alaviali/OBI/Images/IMG_3639.JPG

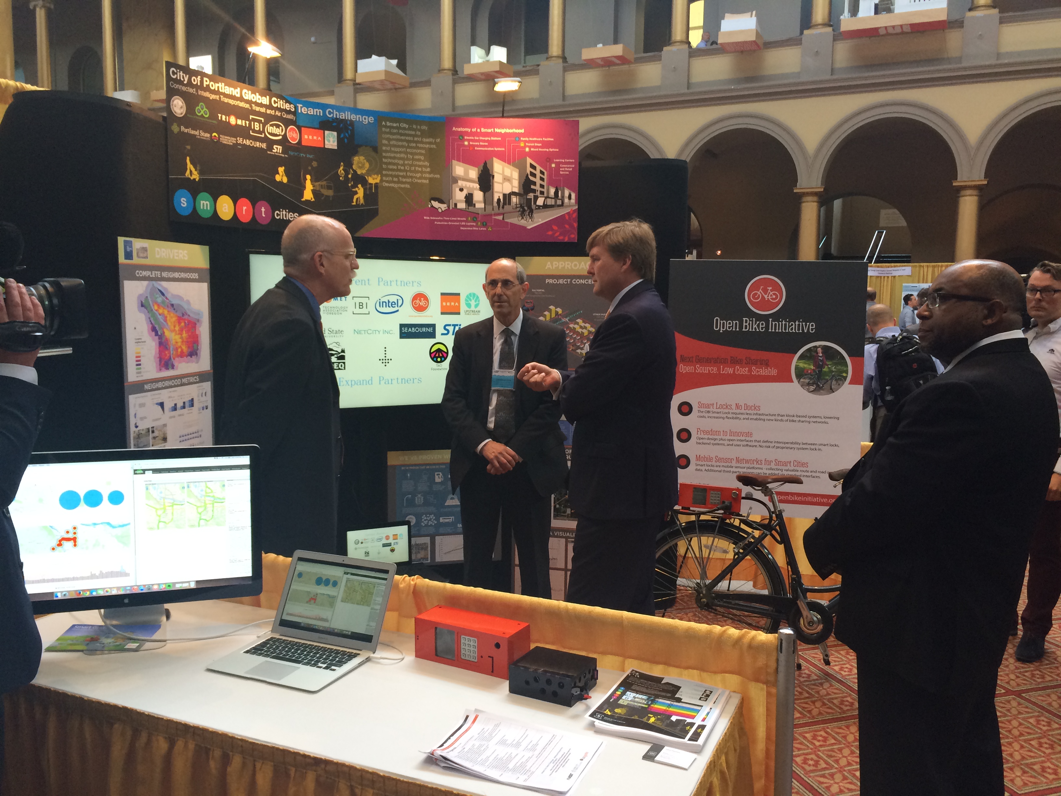
Images/IMG_3639.JPG
