alaviali/OBI/Images and PDFs/PCB_Final.png

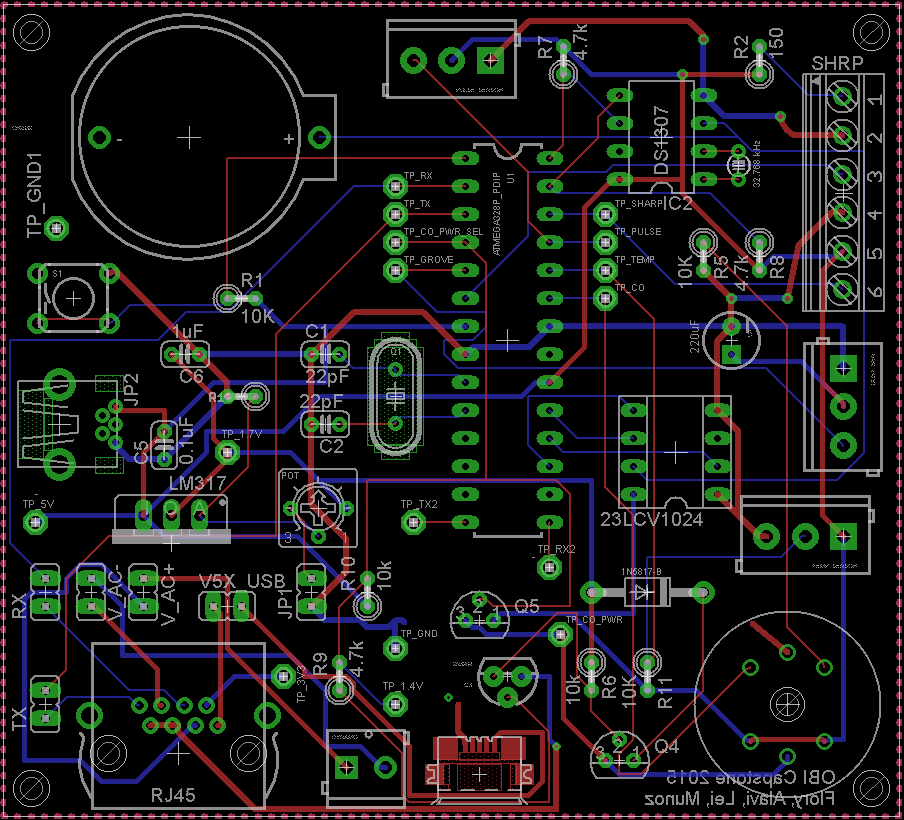
Images and PDFs/PCB_Final.png
