alaviali/OBI/Images and PDFs/Schematic_final.png

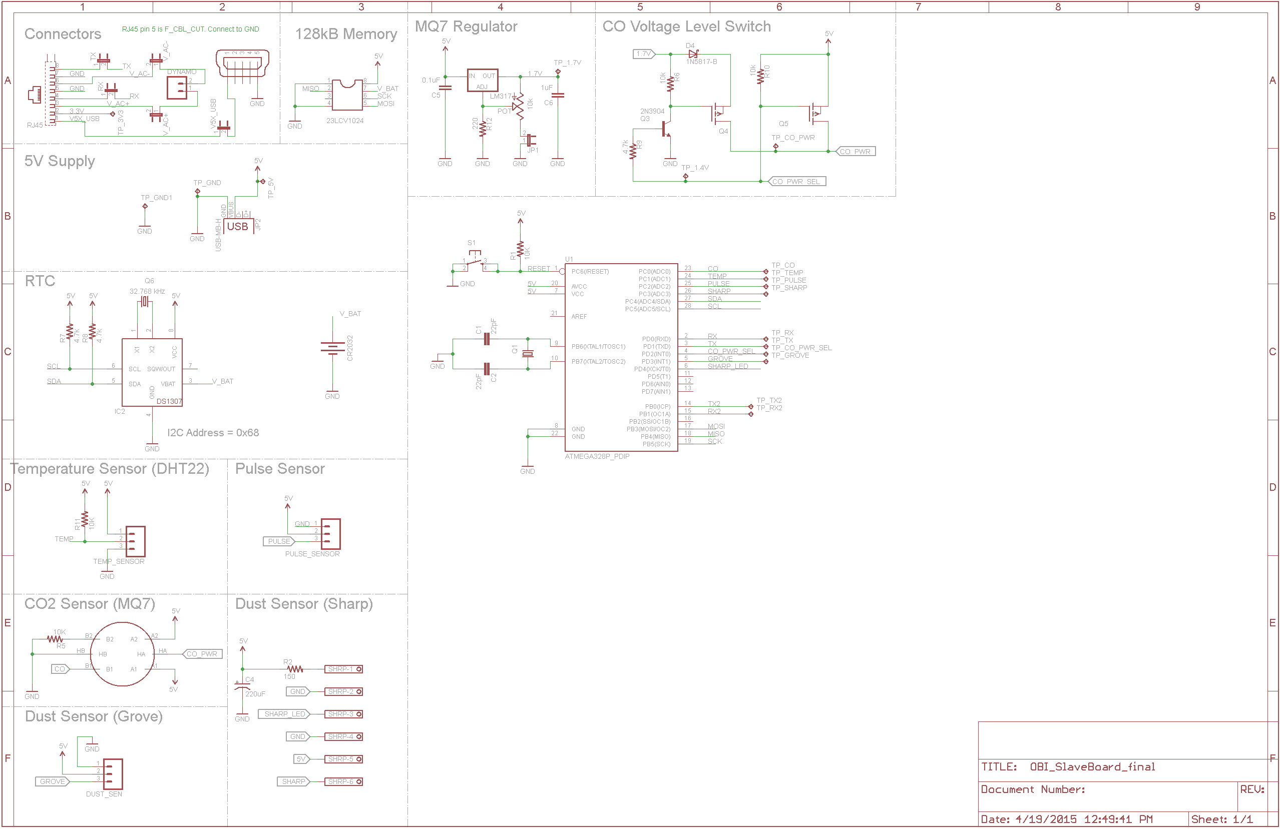
Images and PDFs/Schematic_final.png
