alaviali/OBI/Images/AQSH_ASM_Page_1.jpg

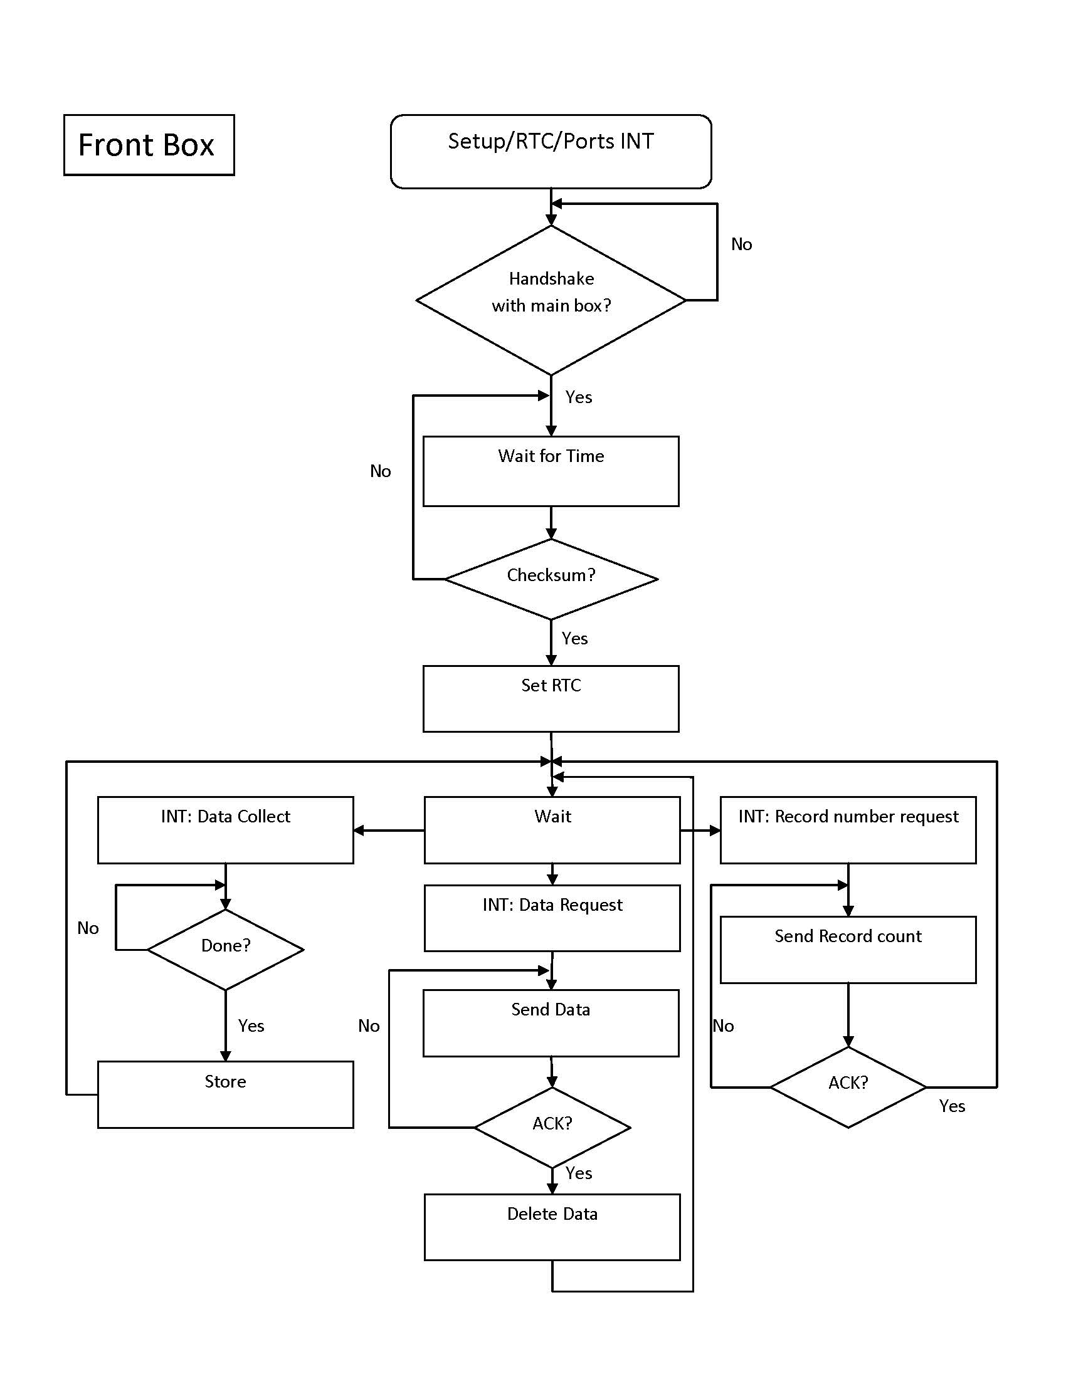
Images/AQSH_ASM_Page_1.jpg
