alaviali/OBI/Images/AQSH_ASM_Page_2.jpg

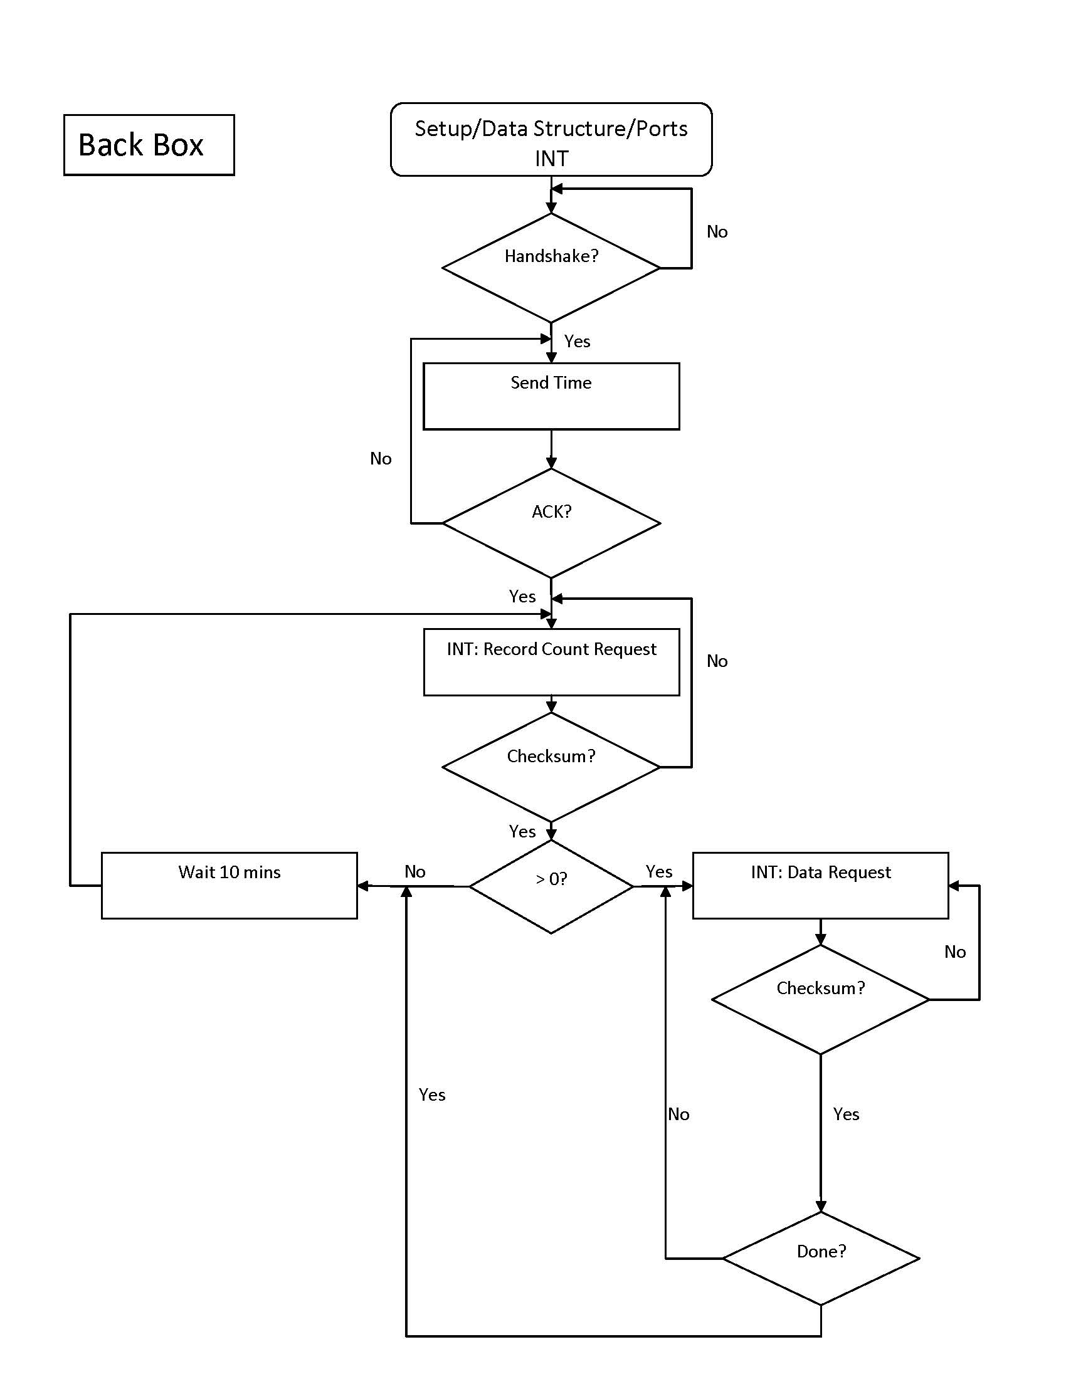
Images/AQSH_ASM_Page_2.jpg
