alaviali/OBI/Images/image7.JPG

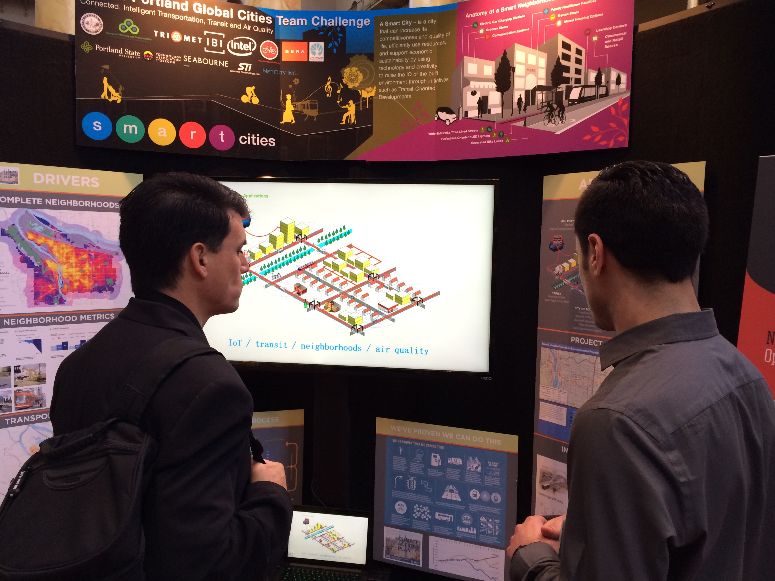
Images/image7.JPG
