alaviali/OBI/Images/IMG_3504.JPG

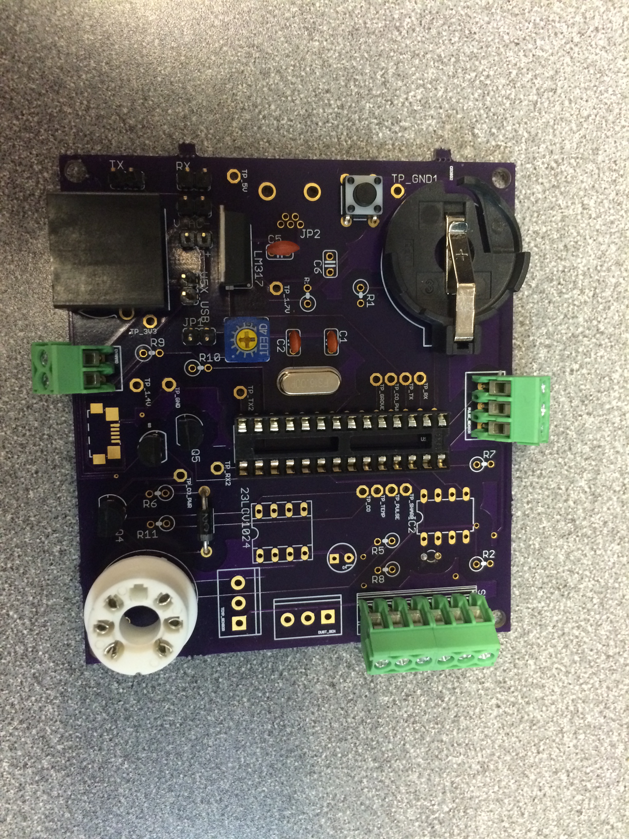
Images/IMG_3504.JPG
