alaviali/OBI/Images/IMG_3506.JPG

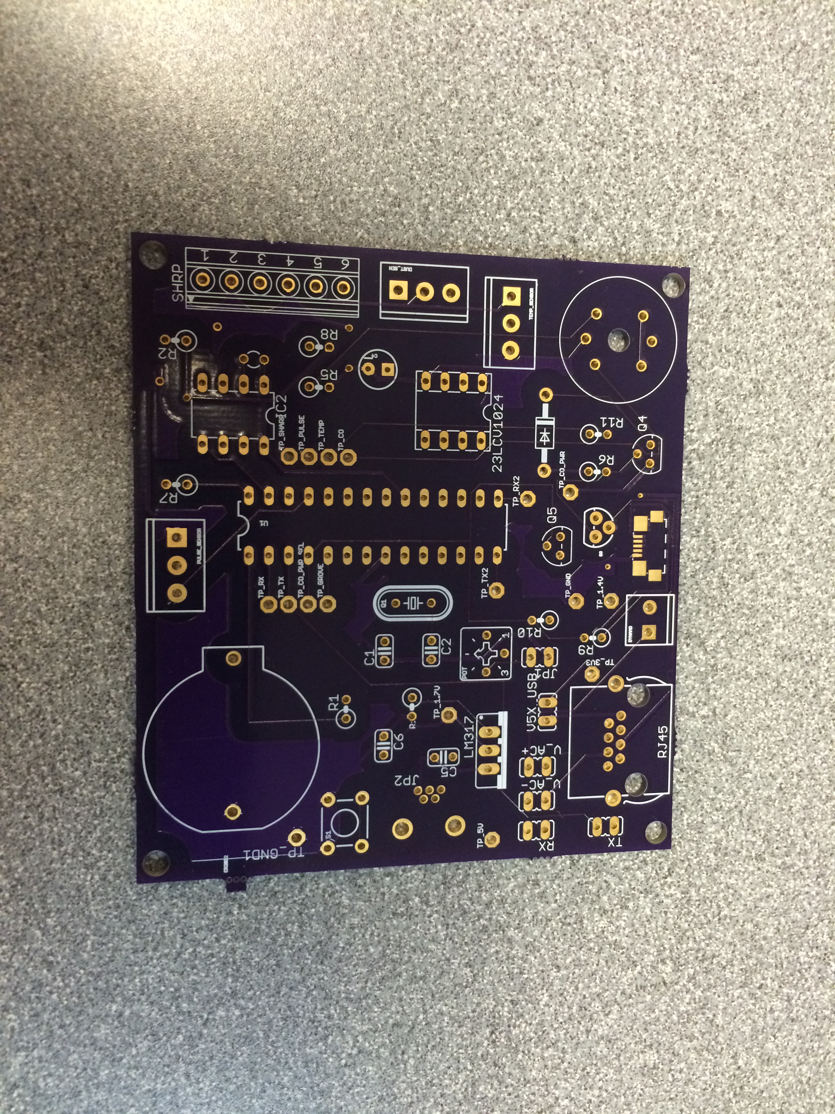
Images/IMG_3506.JPG
