alaviali/OBI/Images/IMG_3590.JPG

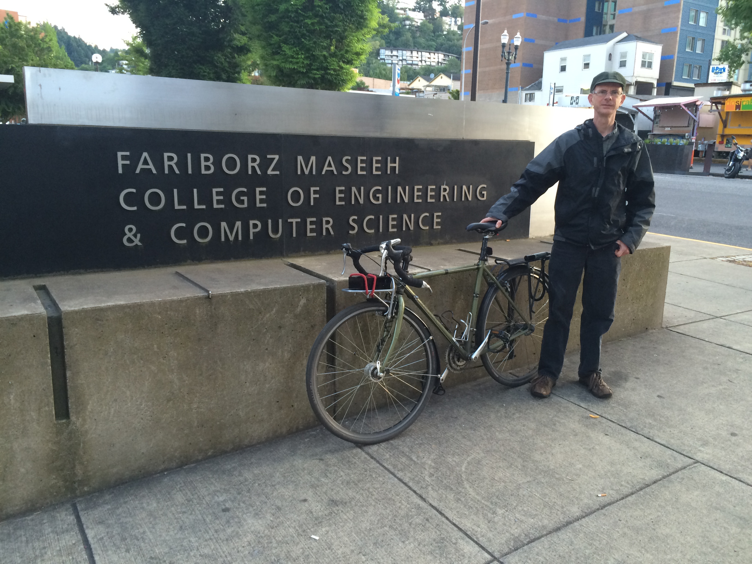
Images/IMG_3590.JPG
