alaviali/OBI/Images/IMG_3593.JPG

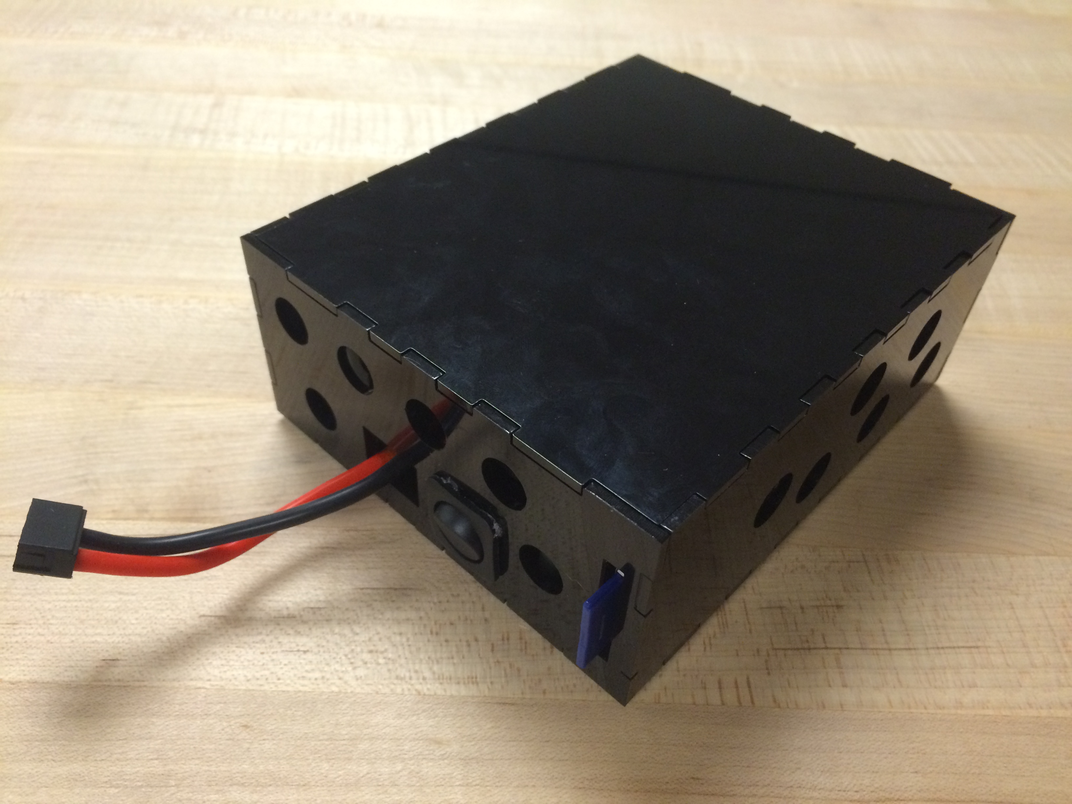
Images/IMG_3593.JPG
