alaviali/OBI/Images/IMG_3595.JPG

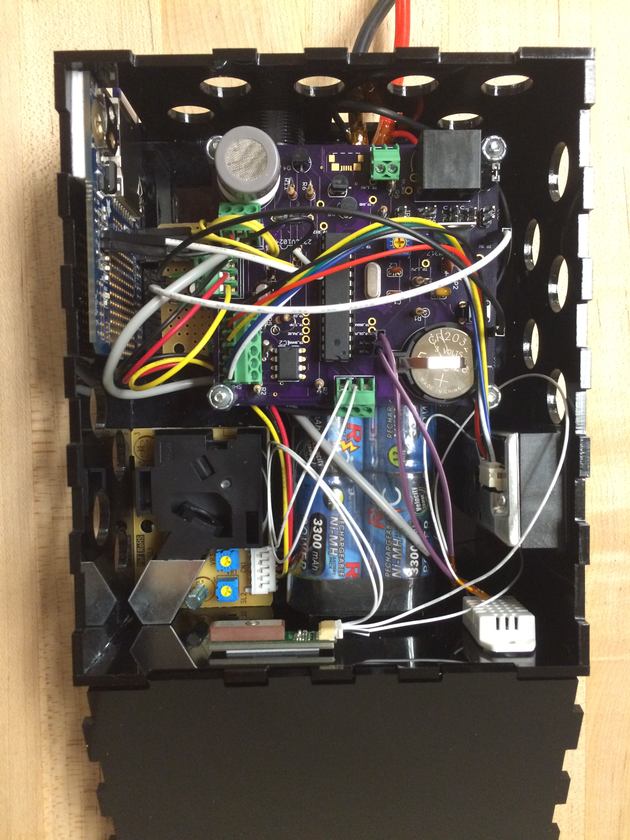
Images/IMG_3595.JPG
