alaviali/OBI/Images/IMG_3659.JPG

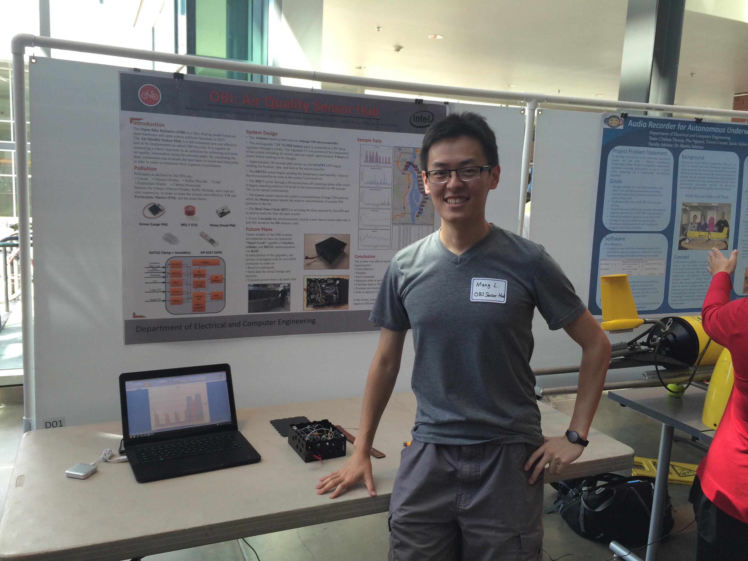
Images/IMG_3659.JPG
