alaviali/OBI/Images/IMG_20150605_155130 (1).jpg

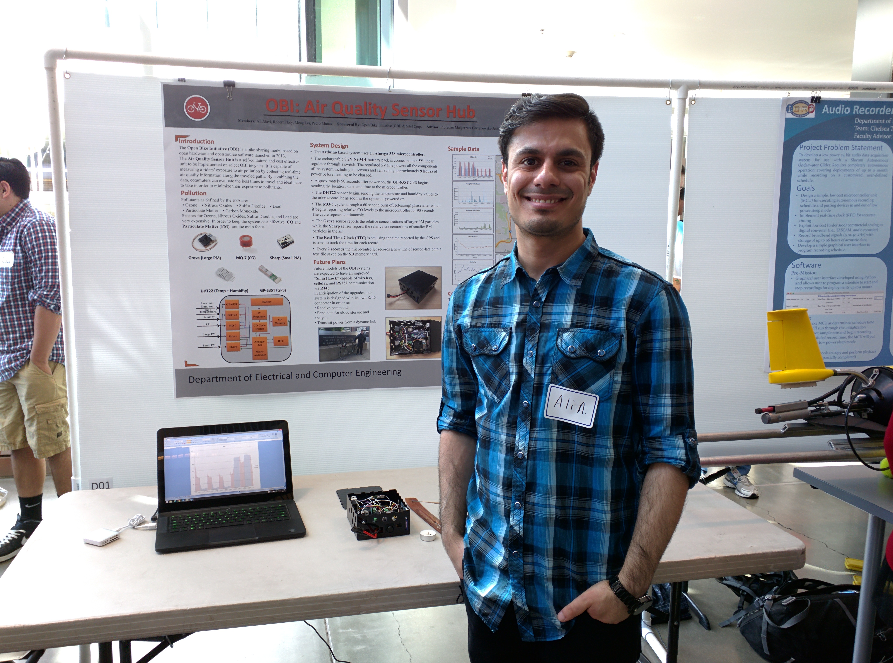
Images/IMG_20150605_155130 (1).jpg
