alaviali/OBI/Images/Schematic-modified.jpg

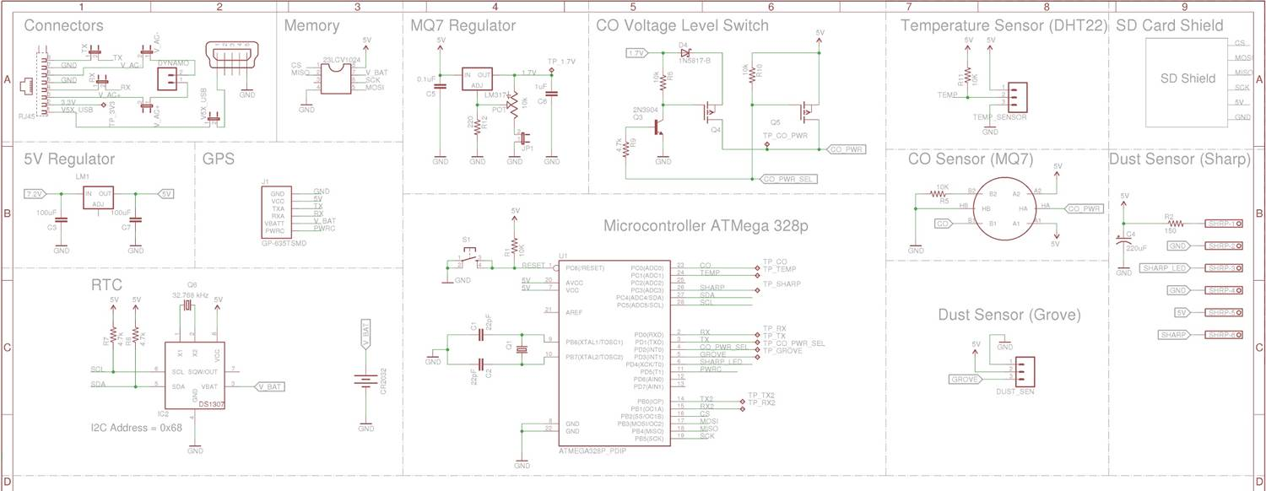
Images/Schematic-modified.jpg
