alaviali/OBI/UML/Capstone UML_Page_01.jpg

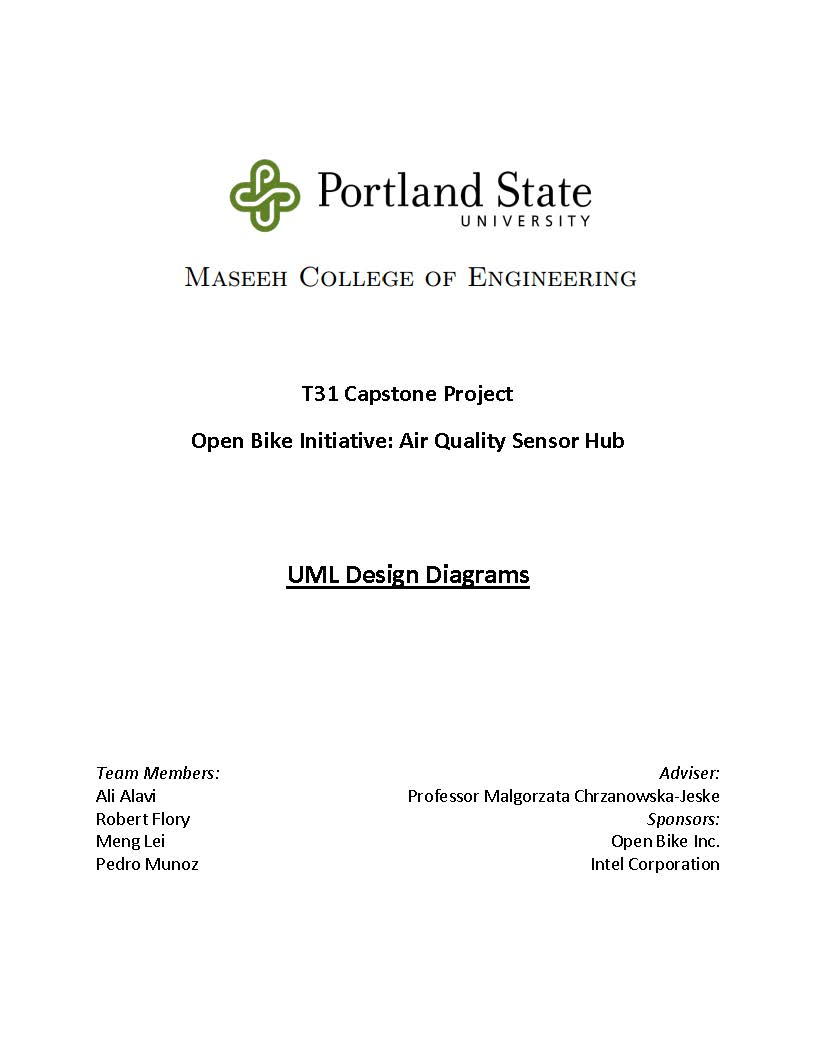
UML/Capstone UML_Page_01.jpg
