alaviali/OBI/UML/Capstone UML_Page_02.jpg

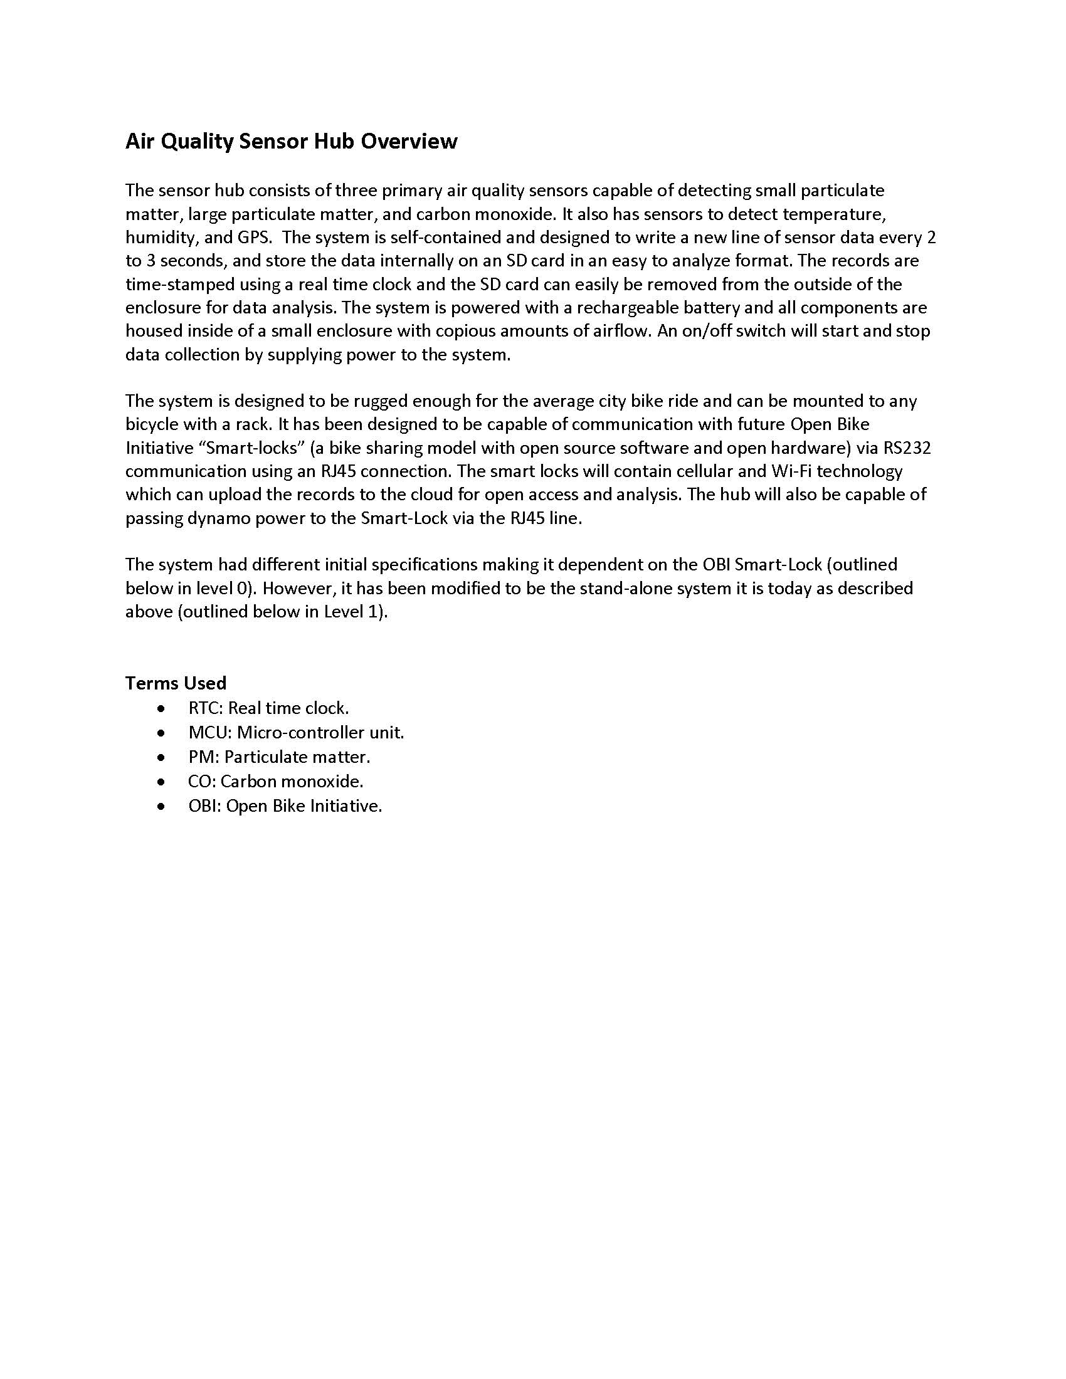
UML/Capstone UML_Page_02.jpg
