alaviali/OBI/UML/Capstone UML_Page_03.jpg

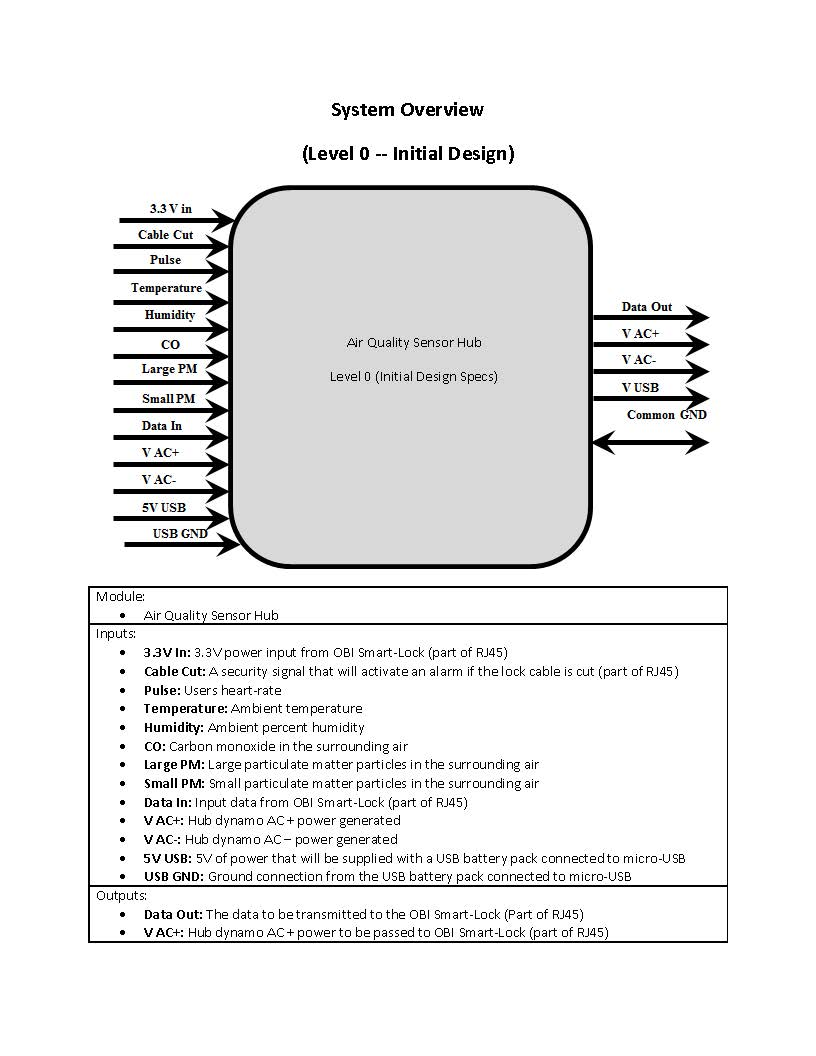
UML/Capstone UML_Page_03.jpg
