alaviali/OBI/UML/Capstone UML_Page_04.jpg

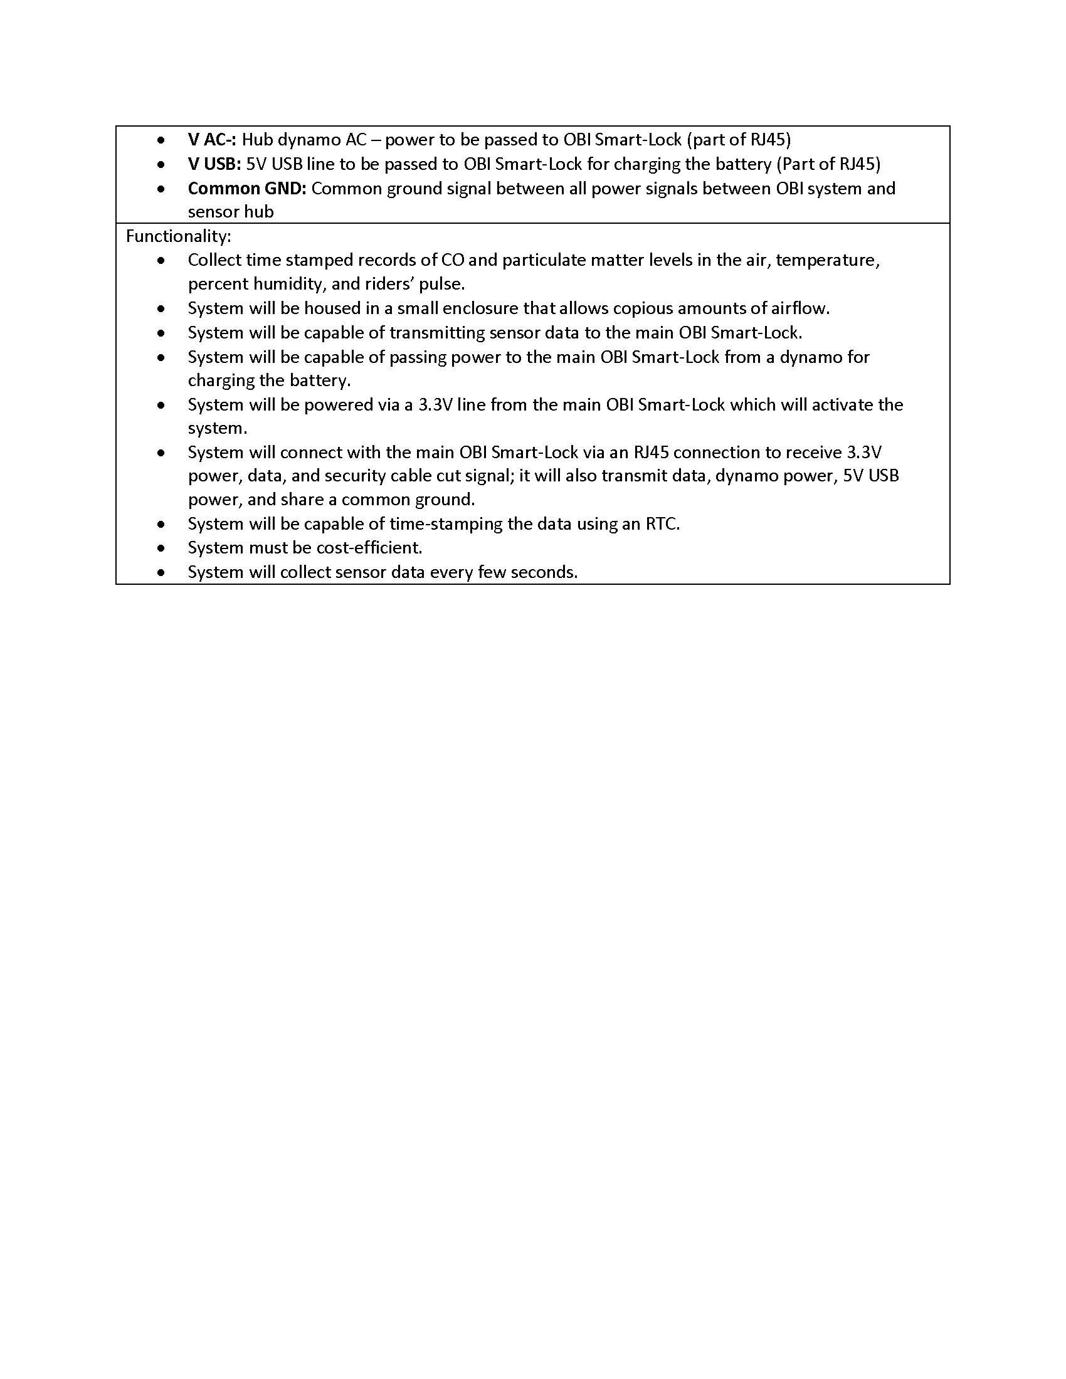
UML/Capstone UML_Page_04.jpg
