alaviali/OBI/UML/Capstone UML_Page_05.jpg

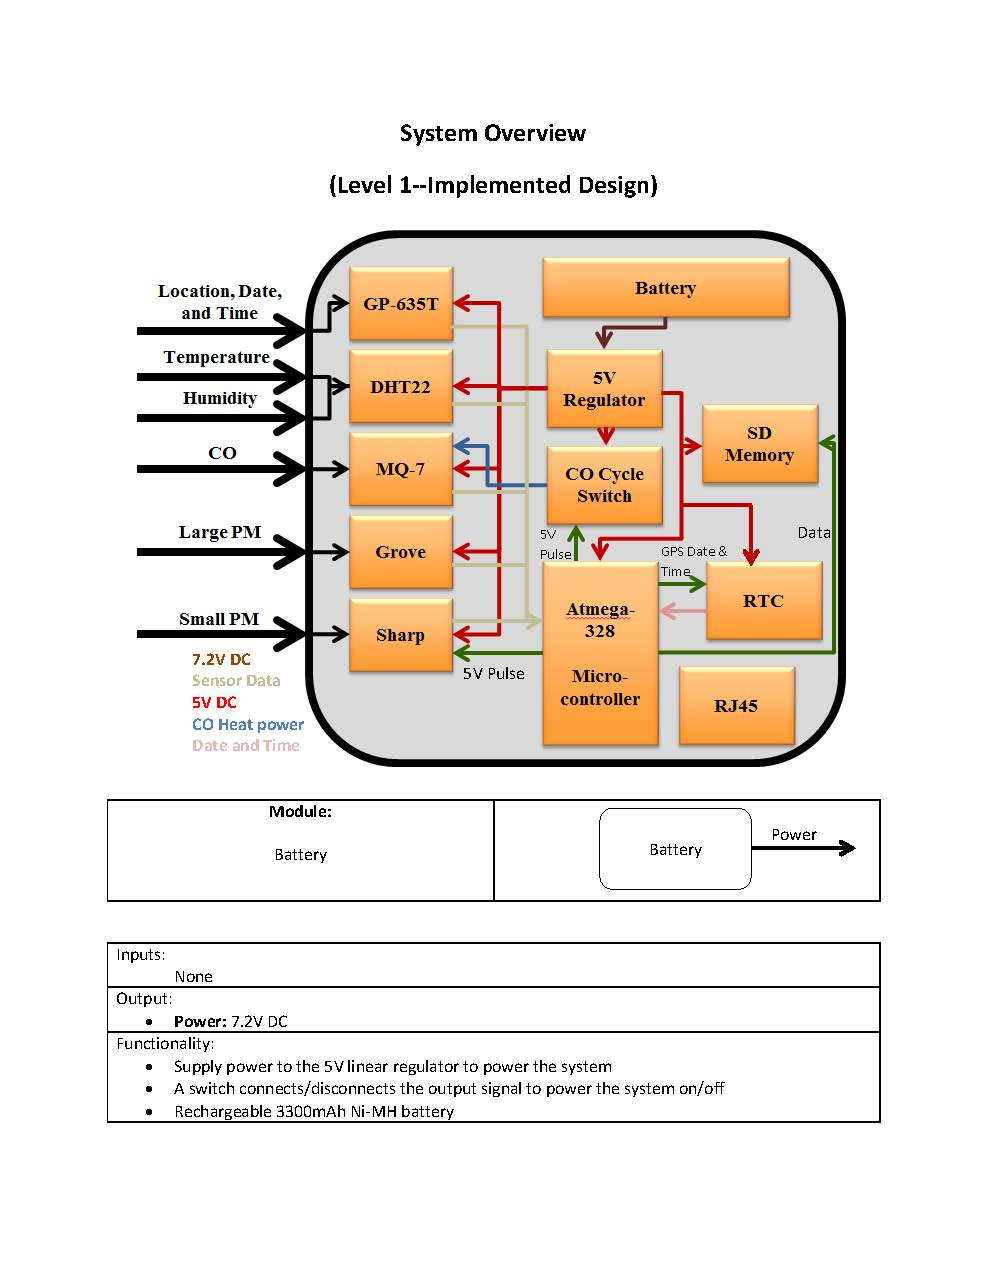
UML/Capstone UML_Page_05.jpg
