alaviali/OBI/UML/Capstone UML_Page_06.jpg

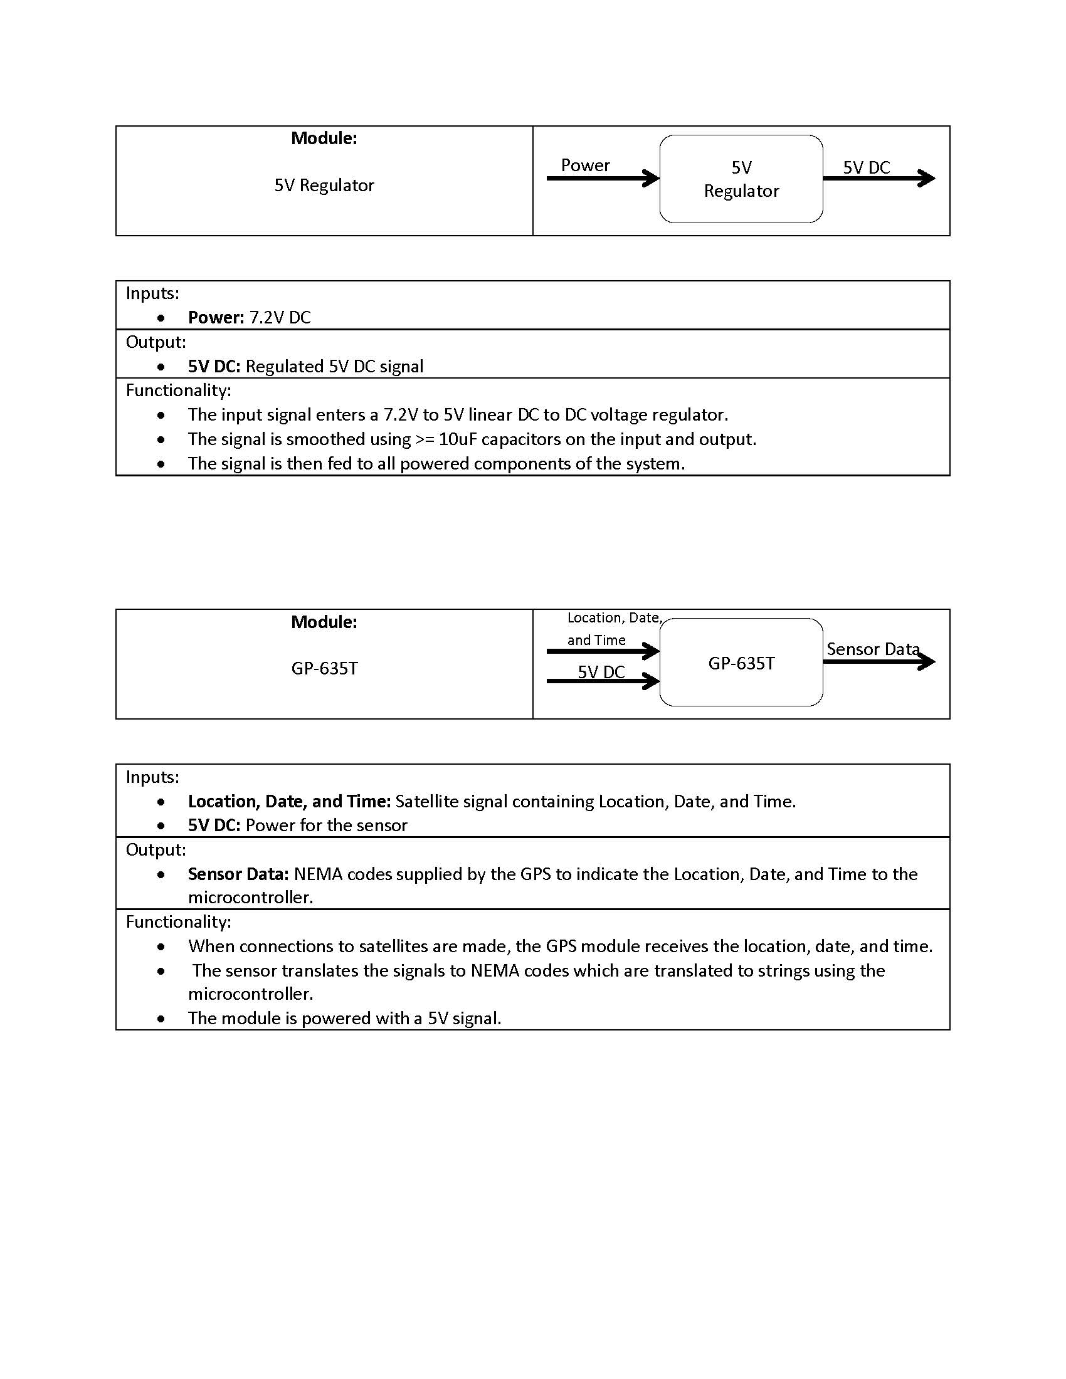
UML/Capstone UML_Page_06.jpg
