alaviali/OBI/UML/Capstone UML_Page_07.jpg

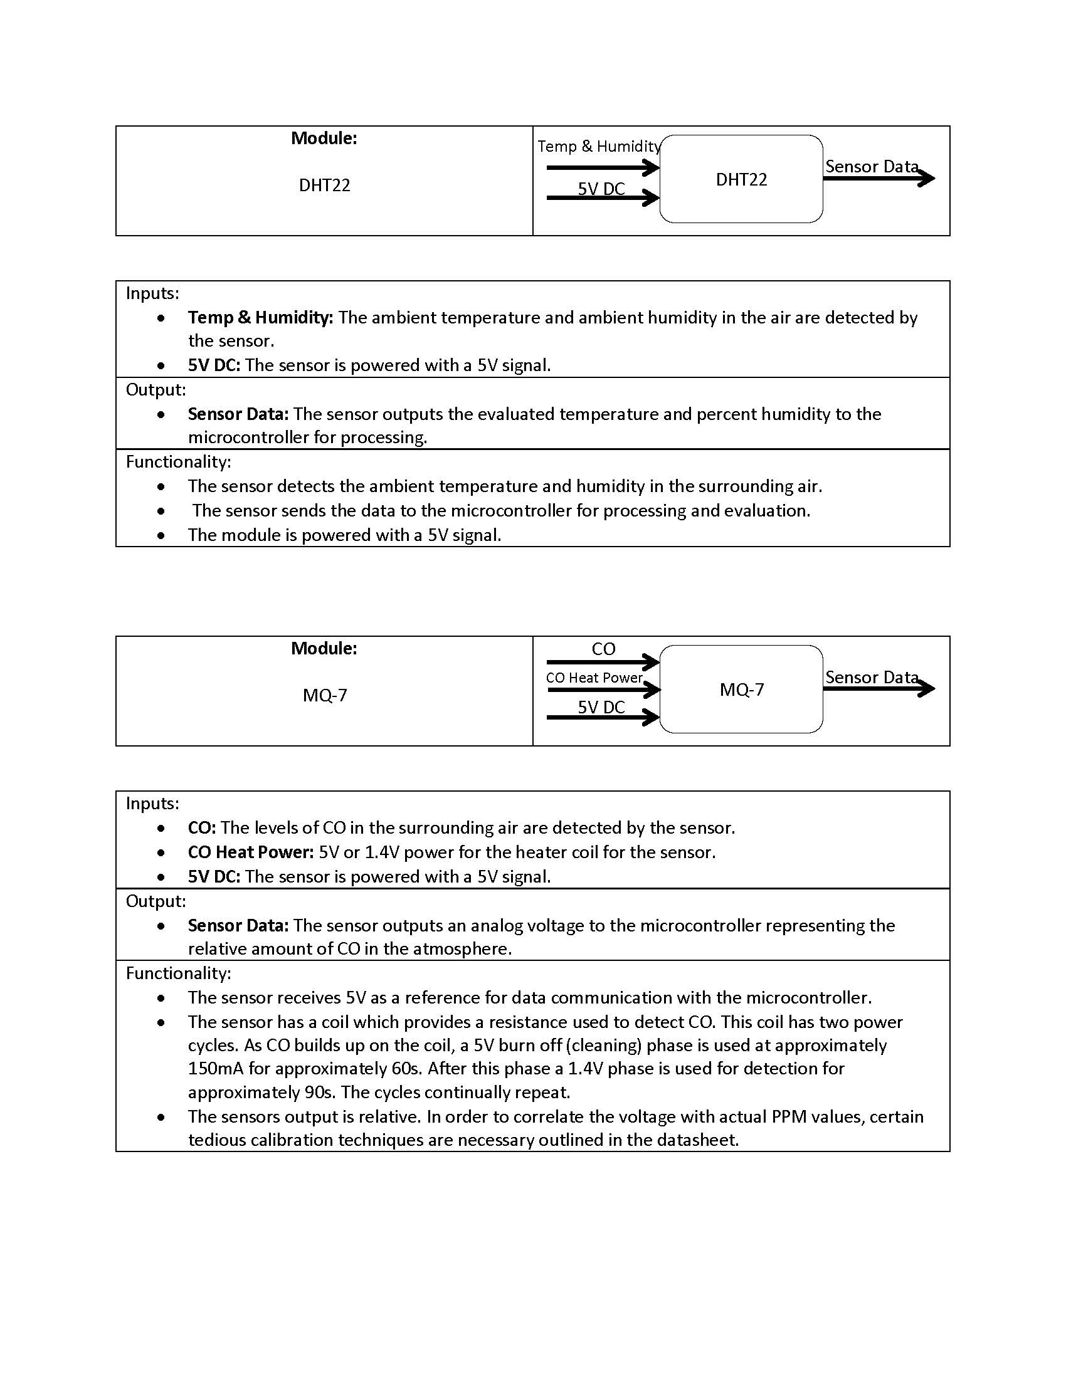
UML/Capstone UML_Page_07.jpg
