alaviali/OBI/UML/Capstone UML_Page_08.jpg

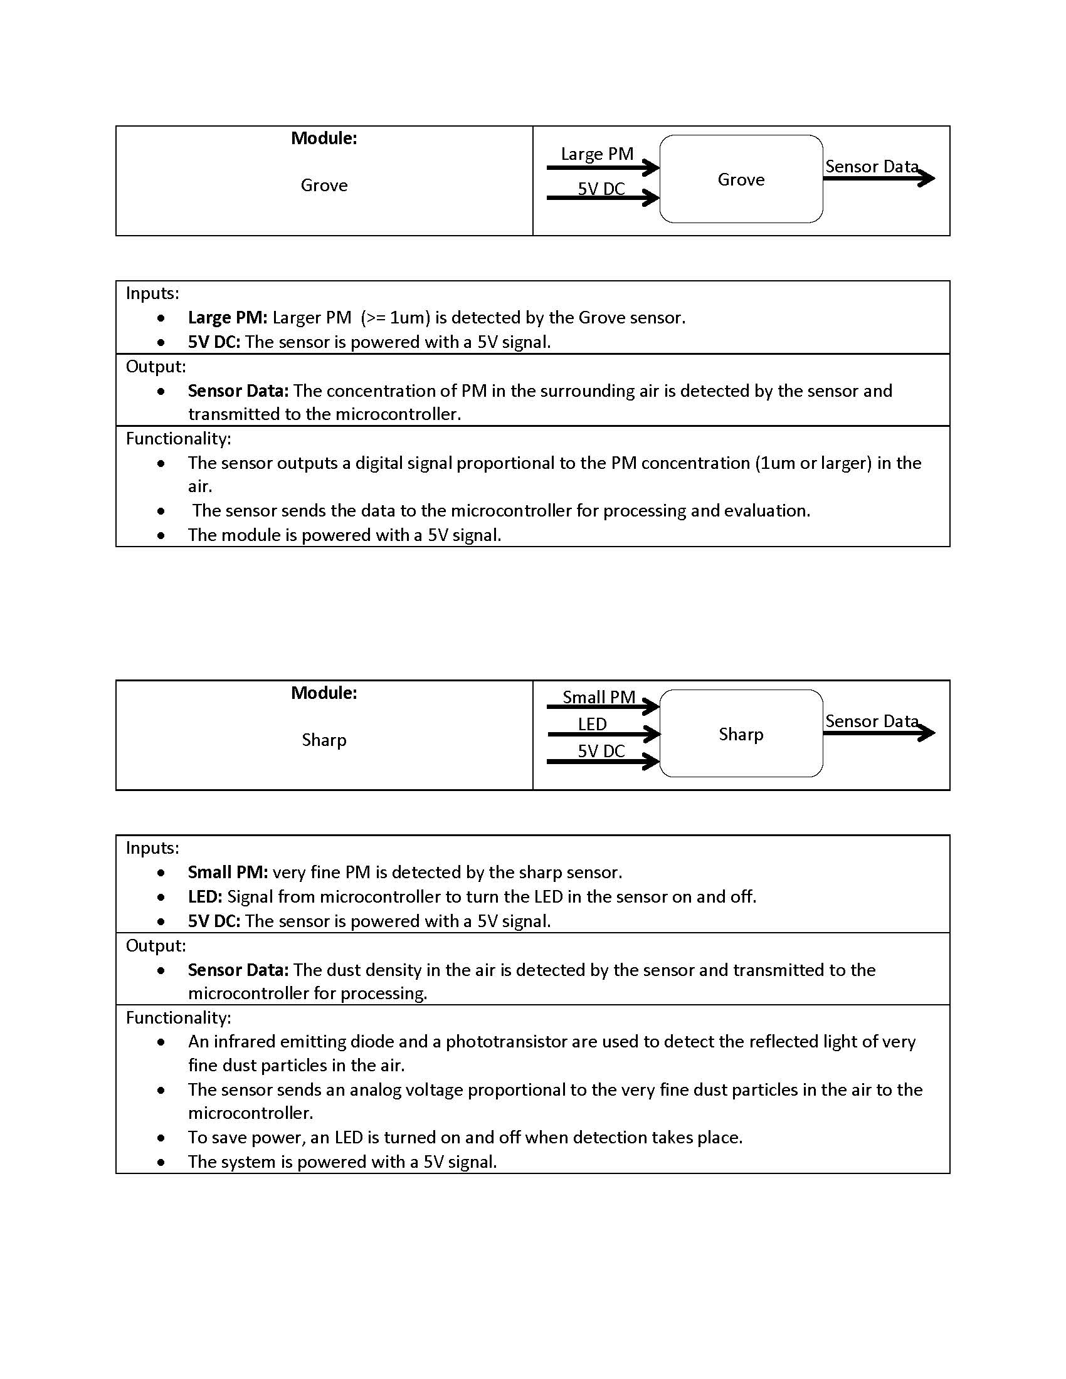
UML/Capstone UML_Page_08.jpg
