alaviali/OBI/UML/Capstone UML_Page_09.jpg

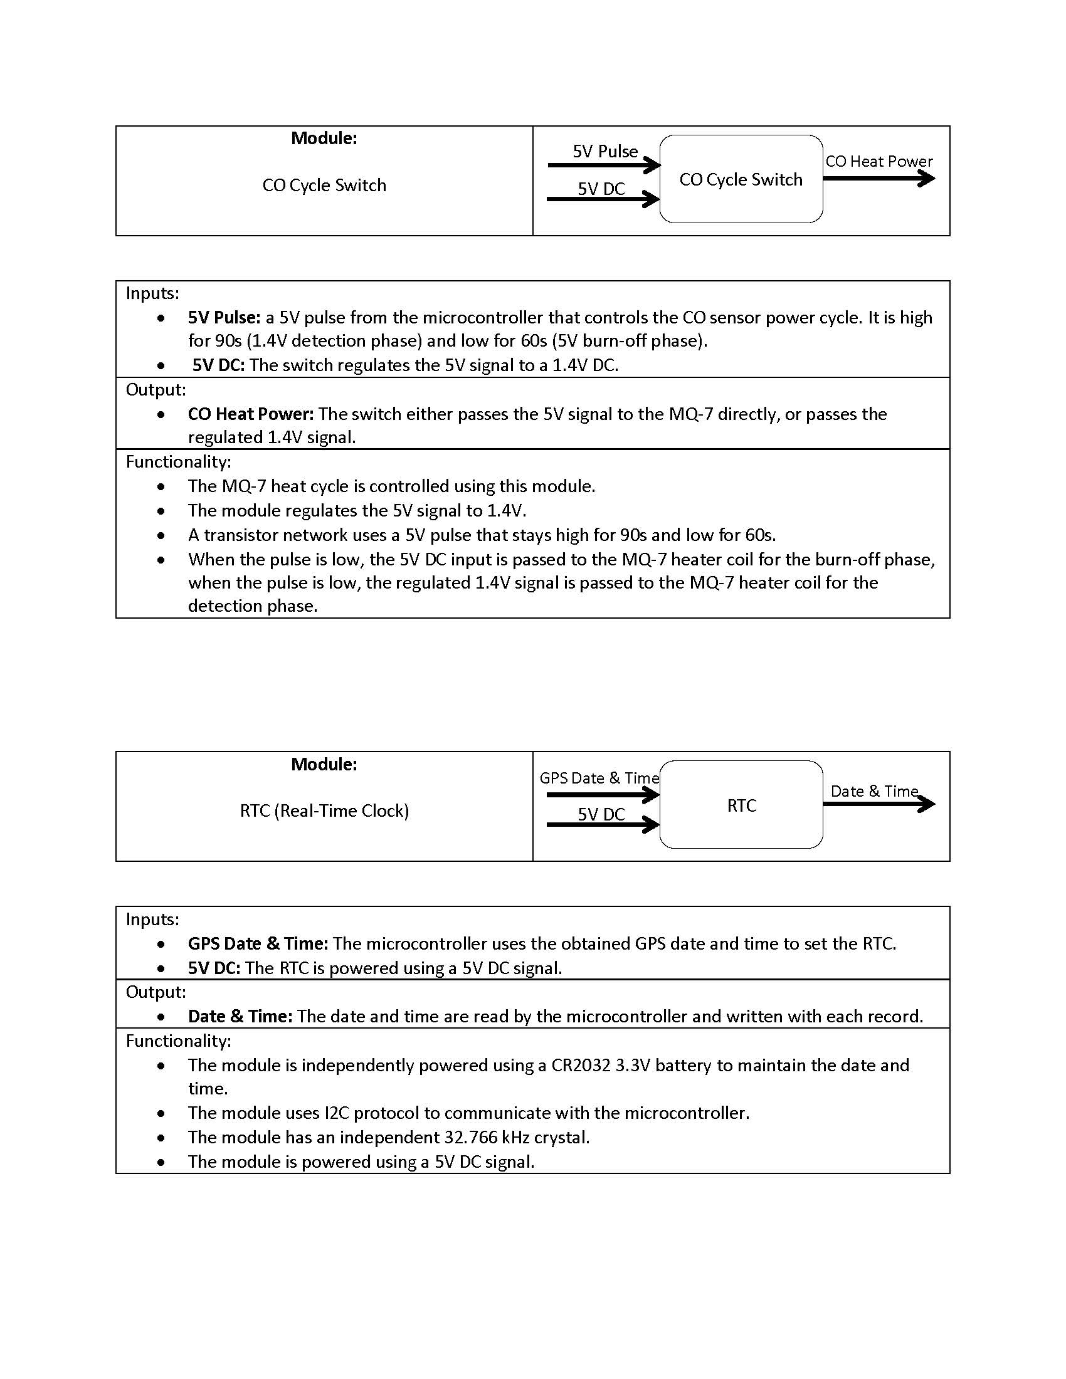
UML/Capstone UML_Page_09.jpg
