alaviali/OBI/UML/Capstone UML_Page_10.jpg

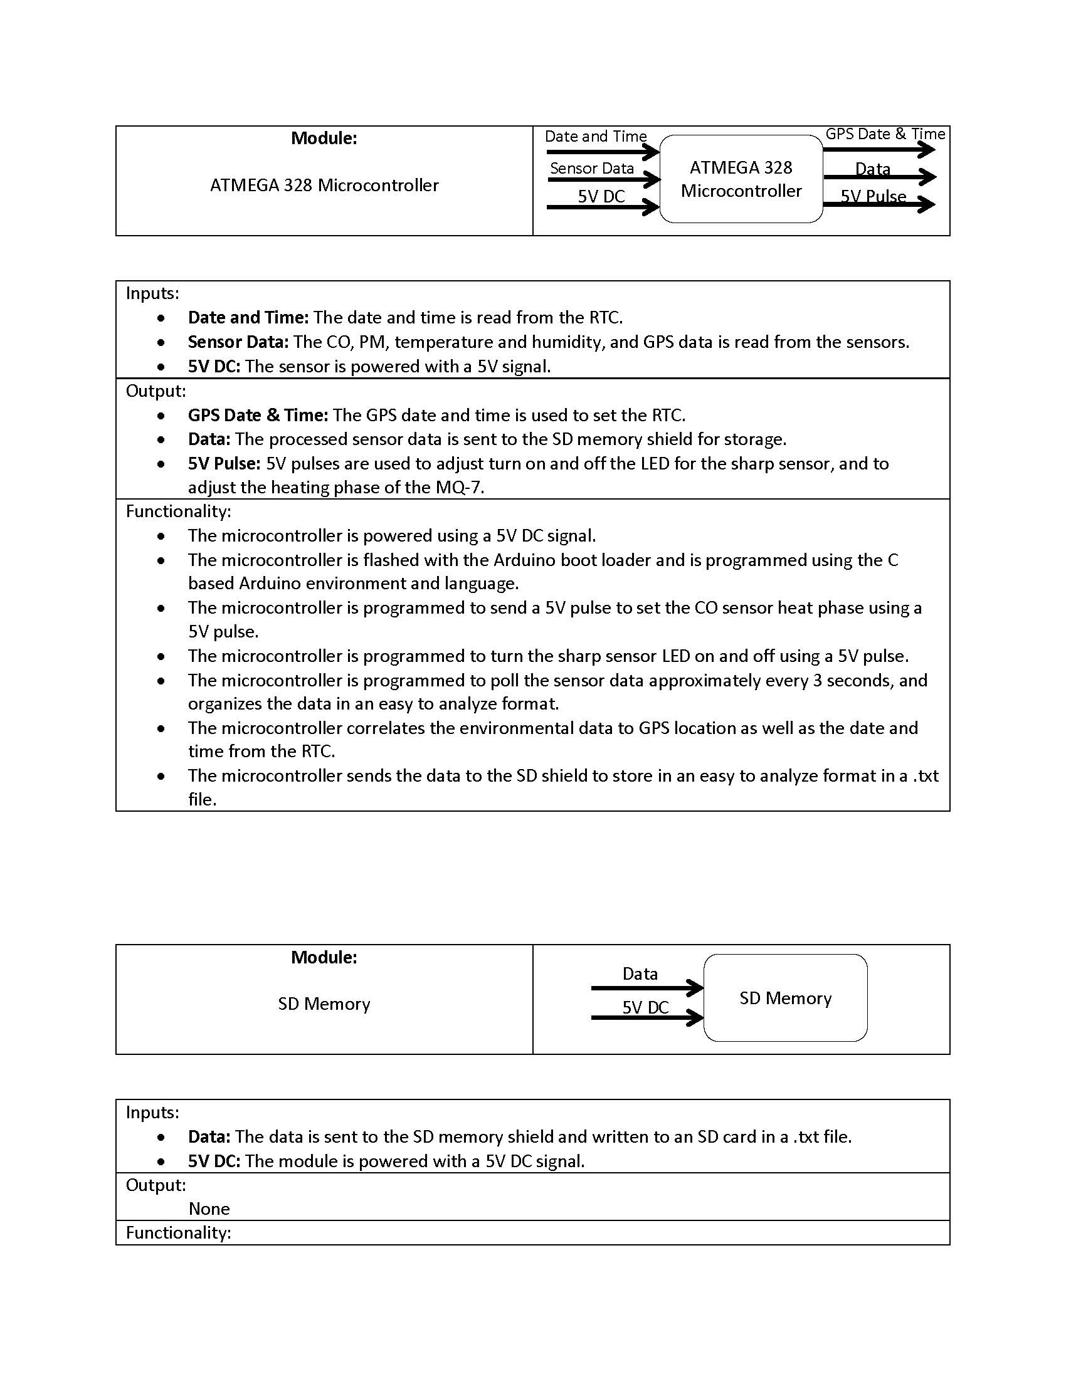
UML/Capstone UML_Page_10.jpg
