alaviali/OBI/UML/Capstone UML_Page_11.jpg

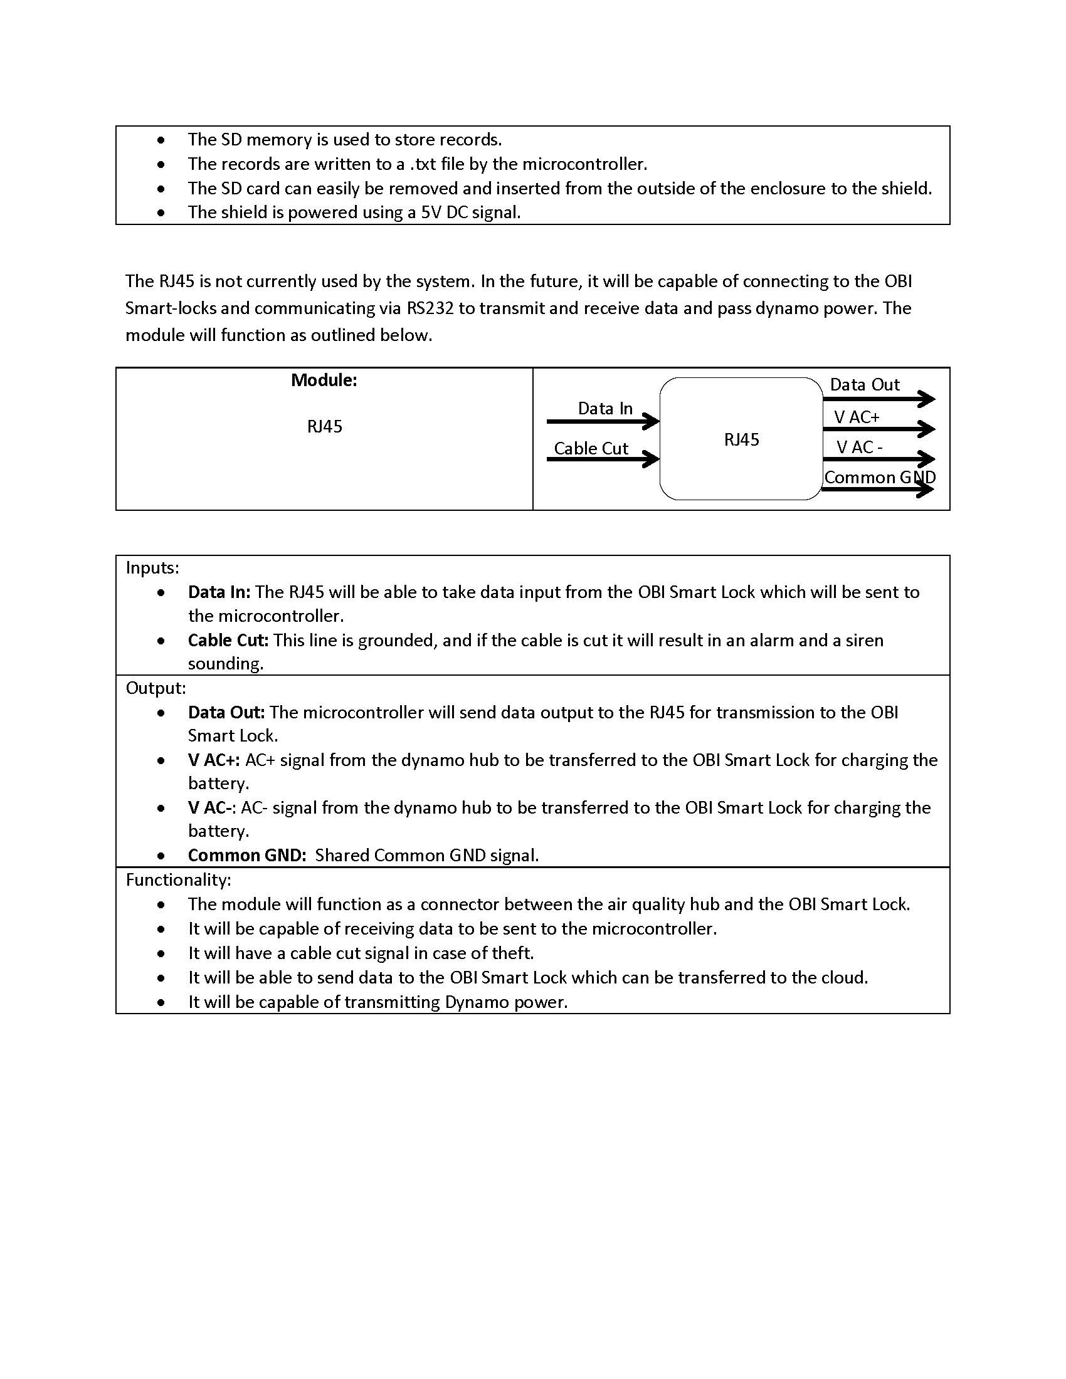
UML/Capstone UML_Page_11.jpg
