alaviali/OBI/(threads)

Thread 2 (2015-03-29):

CO Power Switching

alaviali, 2015-03-29:
Determine the best method for switching power for the CO circuit. If a low power SPDT switch can be found, that may be the best method. Roberts transistor method can also be used but will require more components, or, alternatively, two relays and an inverter can also be used.

Closed 2015-03-29.

Thread 3 (2015-03-29):

Power Consumption

alaviali, 2015-03-29:
The two dust sensors also use some power. It may be necessary to switch to a booster that is capable of supplying more power.

Closed 2015-03-30.

Thread 4 (2015-03-29):

Schematic

alaviali, 2015-03-29:
Schematic needs to be completed and requires that the other issues be addressed in order to do so.
Other modifications:
- Find micro-USB package (currently using mini)
- Find alternate package for reset switch
- Find alternate package for 16 MHz crystal
- Few others that Robert can shed light on

Closed 2015-04-01.

Thread 5 (2015-03-30):

Programming issue: changing from polling to interrupt

raymon-pdx, 2015-03-30:
"Power on->Start Collecting Data->On Serial signal from rear box: start uploading data->Go back to collecting data
One exceptional case that I see is: No signal from the front box to upload data->memory is full->stop collecting data and wait for serial signal from rear box."

So apparently there shouldn't be any polling or hard delays, everything is based on interrupt.

Closed 2015-04-01.

Thread 7 (2015-04-07):

Determine RJ45 coupling

alaviali, 2015-04-07:
Determine RJ45 coupling to avoid cross-talk.

Closed 2015-05-30.
