alaviali/OBI/Schedule/OBI_AQSH_Sched.pdf

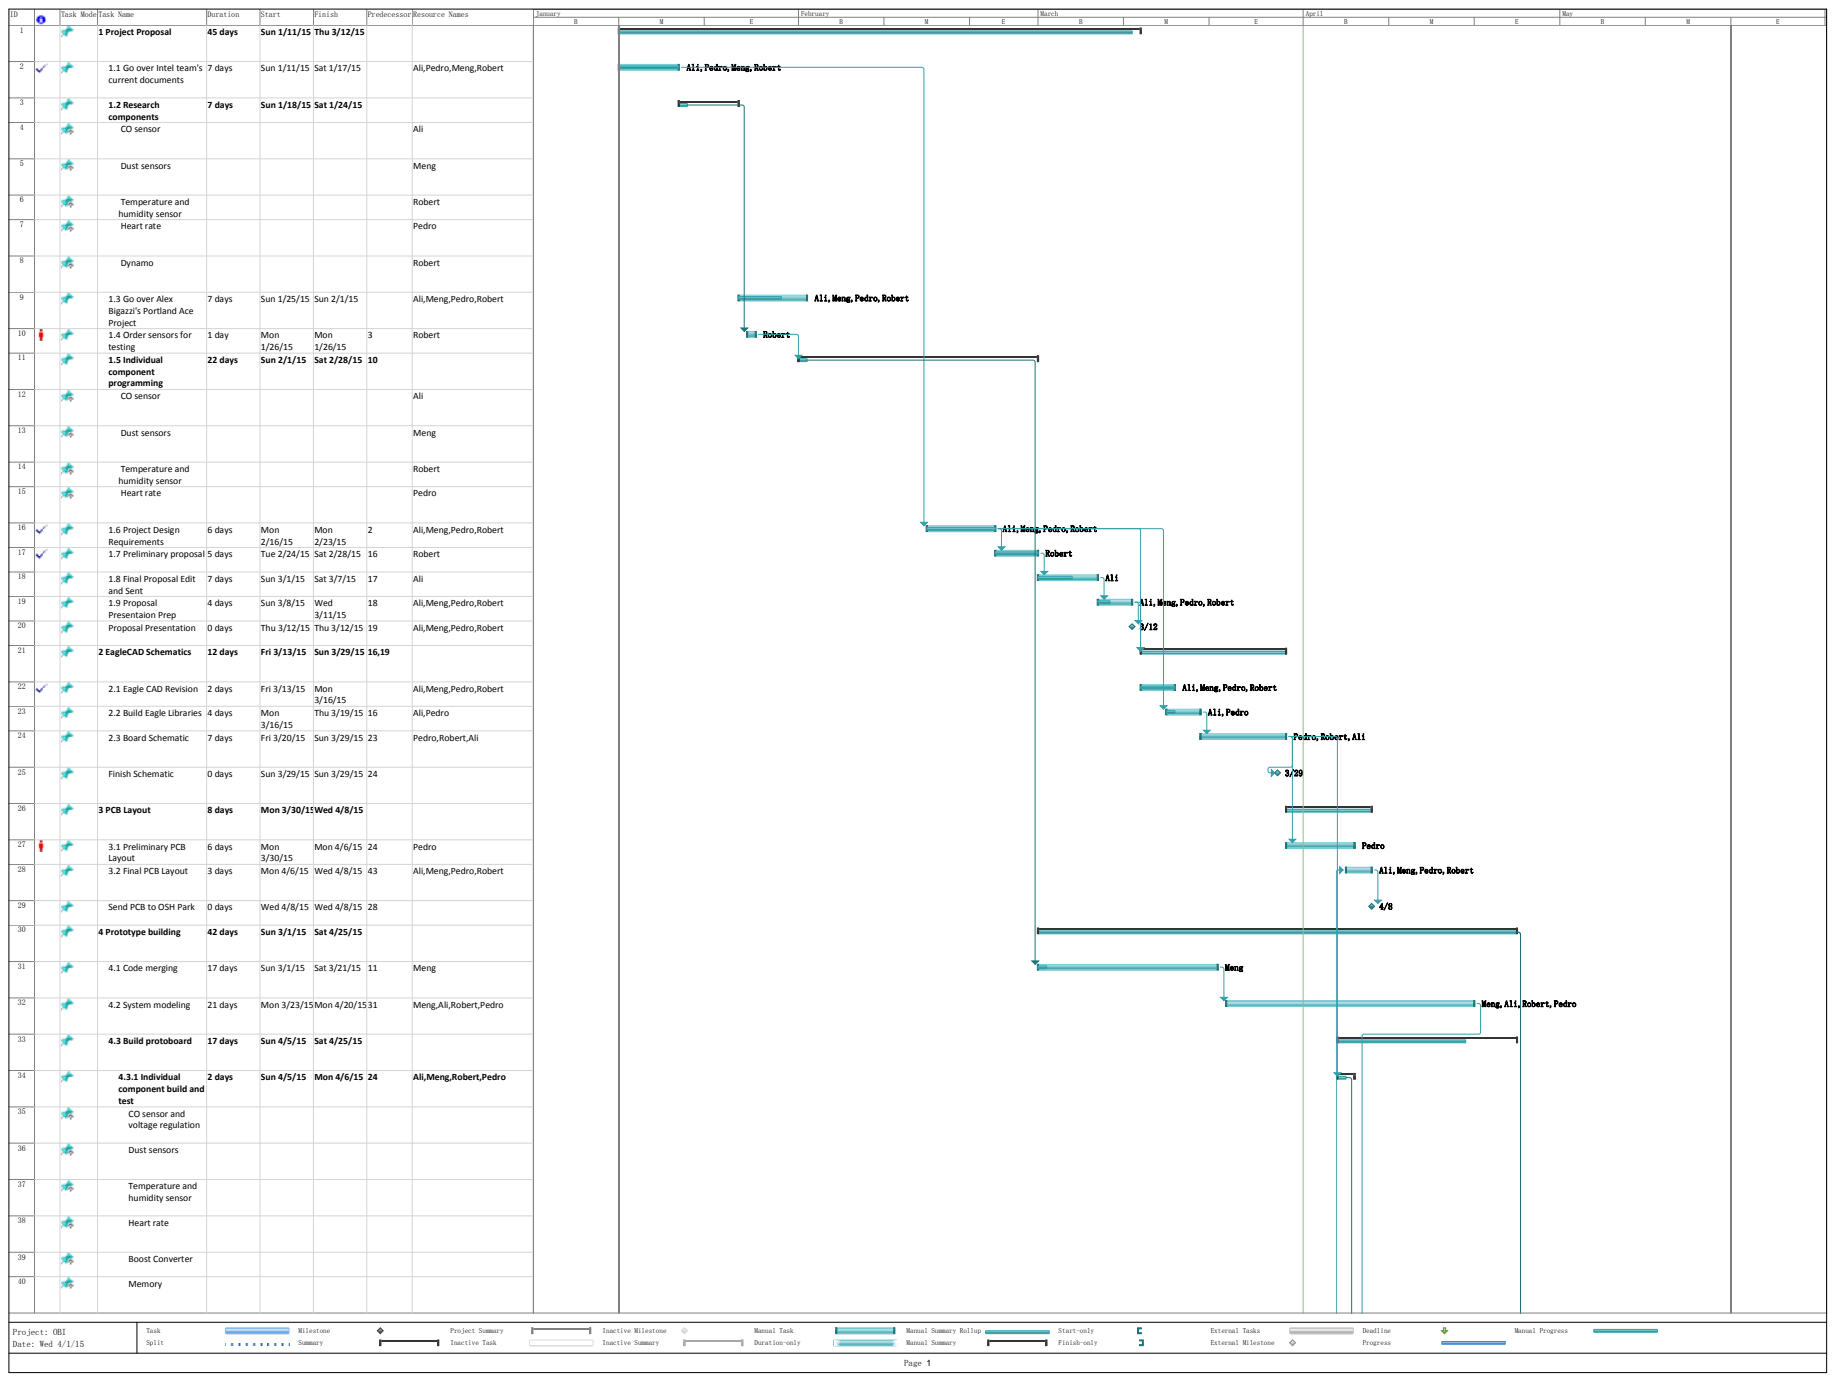
[picture p76: page 1]
Robert; Ali; Ali,Pedro; Pedro; Task; Split; Milestone; Summary; Project Summary; Inactive Task; Inactive Milestone; Inactive Summary; Manual Task; Duration-only; Start-only; Finish-only; External Tasks; External Milestone; Deadline; Progress; Manual Progress; Project: OBI Date: Wed 4/1/15

ID | Task Mode Task Name | | Duration | Start | Finish | Predecessor Resource Names | | January February March April May
1 | | 1 Project Proposal | 45 days | Sun 1/11/15 | Thu 3/12/15 | | | | Ali,Meng,Pedro,Robert

2 | | 1.1 Go over Intel team's current documents | 7 days | Sun 1/11/15 | Sat 1/17/15 | | Ali,Pedro,Meng,Robert

Ali,Pedro,Meng,Robert

3 | | 1.2 Research components | 7 days | Sun 1/18/15 | Sat 1/24/15

4 | | CO sensor | | | | | Ali

5 | | Dust sensors | | | | | Meng

6 | | Temperature and humidity sensor | | | | | Robert

7 | | Heart rate | | | | | Pedro

8 | | Dynamo | | | | | Robert

9 | | 1.3 Go over Alex Bigazzi's Portland Ace Project | 7 days | Sun 1/25/15 | Sun 2/1/15 | | Ali,Meng,Pedro,Robert

10 | | 1.4 Order sensors for testing | 1 day | Mon 1/26/15 | Mon 1/26/15 | 3 | Robert

11 | | 1.5 Individual component programming | 22 days | Sun 2/1/15 | Sat 2/28/15 | 10

12 | | CO sensor | | | | | Ali

13 | | Dust sensors | | | | | Meng

14 | | Temperature and humidity sensor | | | | | Robert

15 | | Heart rate | | | | | Pedro

16 | | 1.6 Project Design Requirements | 6 days | Mon 2/16/15 | Mon 2/23/15 | 2 | Ali,Meng,Pedro,Robert

Ali,Meng,Pedro,Robert

17 | | 1.7 Preliminary proposal 5 days | | Tue 2/24/15 | Sat 2/28/15 | 16 | Robert

18 | | 1.8 Final Proposal Edit and Sent | 7 days | Sun 3/1/15 | Sat 3/7/15 | 17 | Ali

19 | | 1.9 Proposal Presentaion Prep | 4 days | Sun 3/8/15 | Wed 3/11/15 | 18 | Ali,Meng,Pedro,Robert

20 | | Proposal Presentation | 0 days | Thu 3/12/15 | Thu 3/12/15 | 19 | Ali,Meng,Pedro,Robert

21 | | 2 EagleCAD Schematics | 12 days | Fri 3/13/15 | Sun 3/29/15 | 16,19

22 | | 2.1 Eagle CAD Revision | 2 days | Fri 3/13/15 | Mon 3/16/15 | | Ali,Meng,Pedro,Robert

23 | | 2.2 Build Eagle Libraries | 4 days | Mon 3/16/15 | Thu 3/19/15 | 16 | Ali,Pedro

24 | | 2.3 Board Schematic | 7 days | Fri 3/20/15 | Sun 3/29/15 | 23 | Pedro,Robert,Ali

Pedro,Robert,Ali

25 | | Finish Schematic | 0 days | Sun 3/29/15 | Sun 3/29/15 | 24

26 | | 3 PCB Layout | 8 days | Mon 3/30/15Wed 4/8/15

27 | | 3.1 Preliminary PCB Layout | 6 days | Mon 3/30/15 | Mon 4/6/15 | 24 | Pedro

28 | | 3.2 Final PCB Layout | 3 days | Mon 4/6/15 | Wed 4/8/15 | 43 | Ali,Meng,Pedro,Robert

29 | | Send PCB to OSH Park | 0 days | Wed 4/8/15 | Wed 4/8/15 | 28

30 | | 4 Prototype building | 42 days | Sun 3/1/15 | Sat 4/25/15 | | | | | Meng

31 | | 4.1 Code merging | 17 days | Sun 3/1/15 | Sat 3/21/15 | 11 | Meng

32 | | 4.2 System modeling | 21 days | Mon 3/23/15Mon 4/20/1531 | | | Meng,Ali,Robert,Pedro

Meng,Ali,Robert,Pedro

33 | | 4.3 Build protoboard | 17 days | Sun 4/5/15 | Sat 4/25/15

34 | | 4.3.1 Individual component build and test | 2 days | Sun 4/5/15 | Mon 4/6/15 | 24 | Ali,Meng,Robert,Pedro

35 | | CO sensor and voltage regulation

36 | | Dust sensors

37 | | Temperature and humidity sensor

38 | | Heart rate

39 | | Boost Converter

40 | | Memory

Manual Summary Rollup
Manual Summary

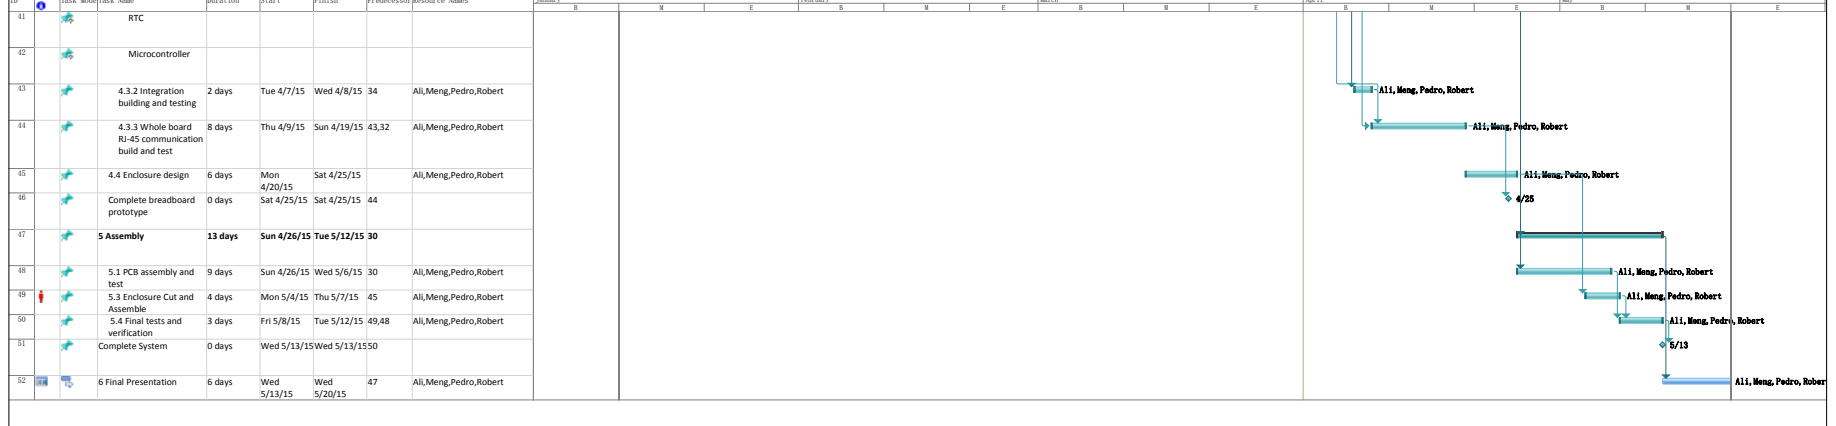
[picture p77: page 2]
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

ID | Task Mode Task Name | | Duration | Start | Finish | Predecessor Resource Names | | January February March April | | May
41 | | RTC | | | | | | | | | Ali,Meng,Pedro,Robert 4/25 | Ali,Meng,Pedro,Robert Ali,Meng,Pedro,Robert Ali,Meng,Pedro,Robert 5/13 | Ali,Meng,Pedro,Robert

42 | | Microcontroller

43 | | 4.3.2 Integration building and testing | 2 days | Tue 4/7/15 | Wed 4/8/15 | 34 | Ali,Meng,Pedro,Robert

Ali,Meng,Pedro,Robert

44 | | 4.3.3 Whole board RJ‐45 communication build and test | 8 days | Thu 4/9/15 | Sun 4/19/15 | 43,32 | Ali,Meng,Pedro,Robert

45 | | 4.4 Enclosure design | 6 days | Mon 4/20/15 | Sat 4/25/15 | | Ali,Meng,Pedro,Robert

46 | | Complete breadboard prototype | 0 days | Sat 4/25/15 | Sat 4/25/15 | 44

47 | | 5 Assembly | 13 days | Sun 4/26/15 | Tue 5/12/15 | 30

48 | | 5.1 PCB assembly and test | 9 days | Sun 4/26/15 | Wed 5/6/15 | 30 | Ali,Meng,Pedro,Robert

49 | | 5.3 Enclosure Cut and Assemble | 4 days | Mon 5/4/15 | Thu 5/7/15 | 45 | Ali,Meng,Pedro,Robert

50 | | 5.4 Final tests and verification | 3 days | Fri 5/8/15 | Tue 5/12/15 | 49,48 | Ali,Meng,Pedro,Robert

51 | | Complete System | 0 days | Wed 5/13/15Wed 5/13/1550

52 | | 6 Final Presentation | 6 days | Wed 5/13/15 | Wed 5/20/15 | 47 | Ali,Meng,Pedro,Robert

Manual Summary Rollup
Manual Summary
