alaviali/OBI/State Machine/AQSH_ASM.pdf

### Setup/RTC/Ports INT

# Front Box

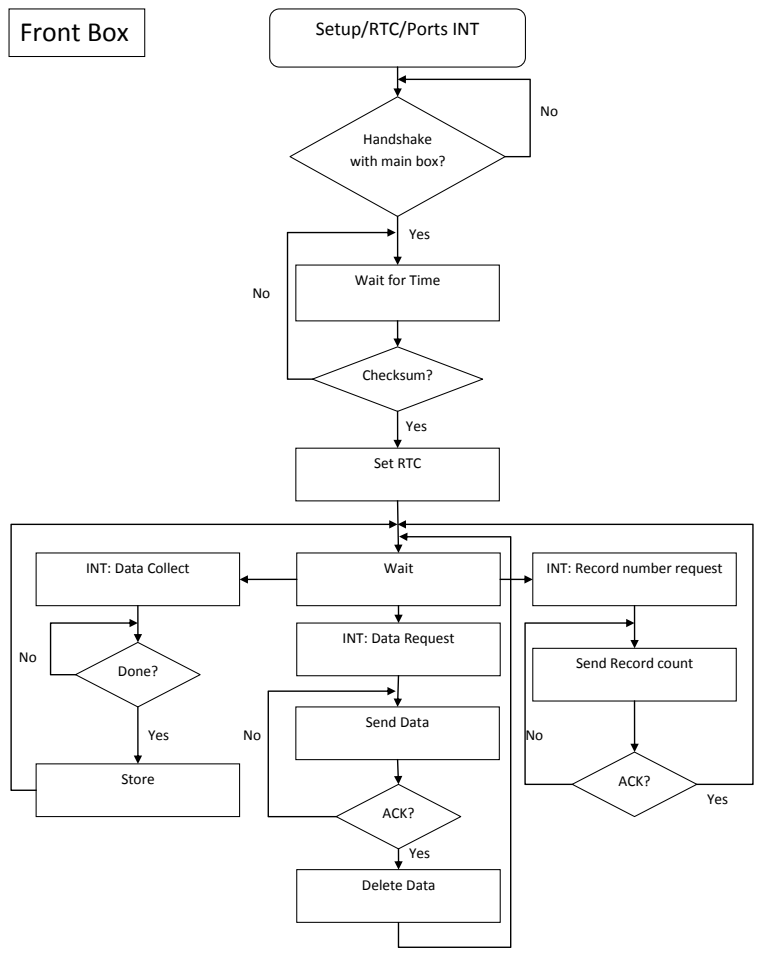
[picture p78: page 1]
Store; ACK?; Done?; Wait; Set RTC; Checksum?; Delete Data; Yes; Send Data

Handshake
with main box?

Wait for Time

INT: Data Collect

INT: Record number request

INT: Data Request

Send Record count

### Setup/Data Structure/Ports INT

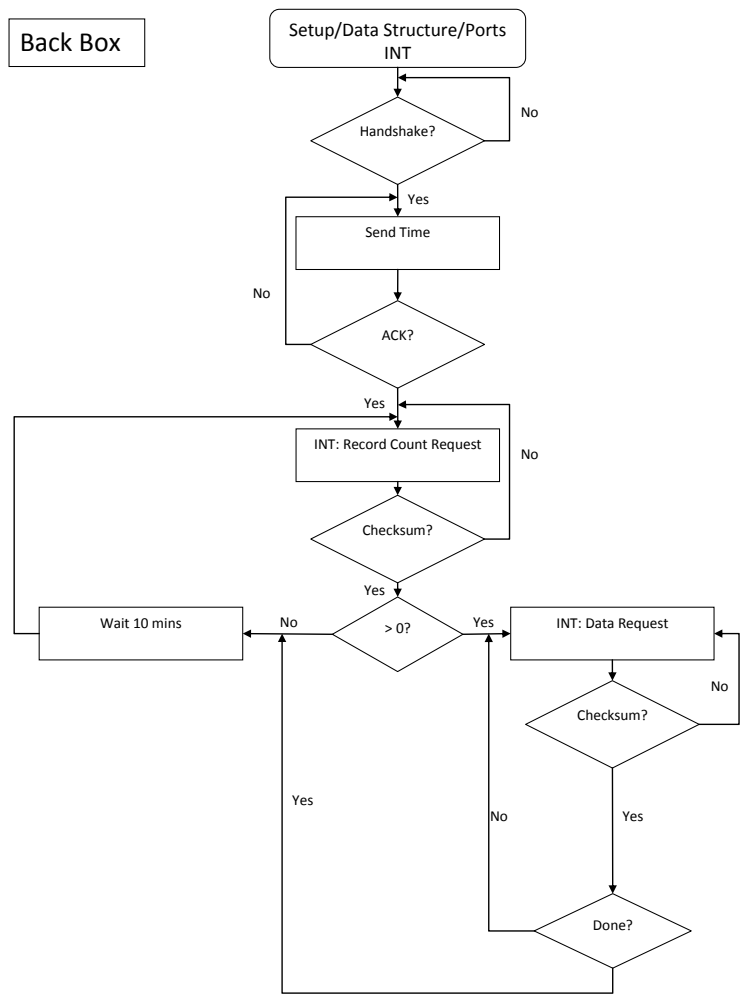
[picture p79: page 2]
Handshake?; Send Time; ACK?; INT: Data Request; Done?; Wait 10 mins; Checksum?; Back Box; Yes

INT: Record Count Request
