alaviali/OBI/Layout/OBI_SlaveBoard_final.brd

## EAGLE design Layout/OBI_SlaveBoard_final.brd (2015-04-19)

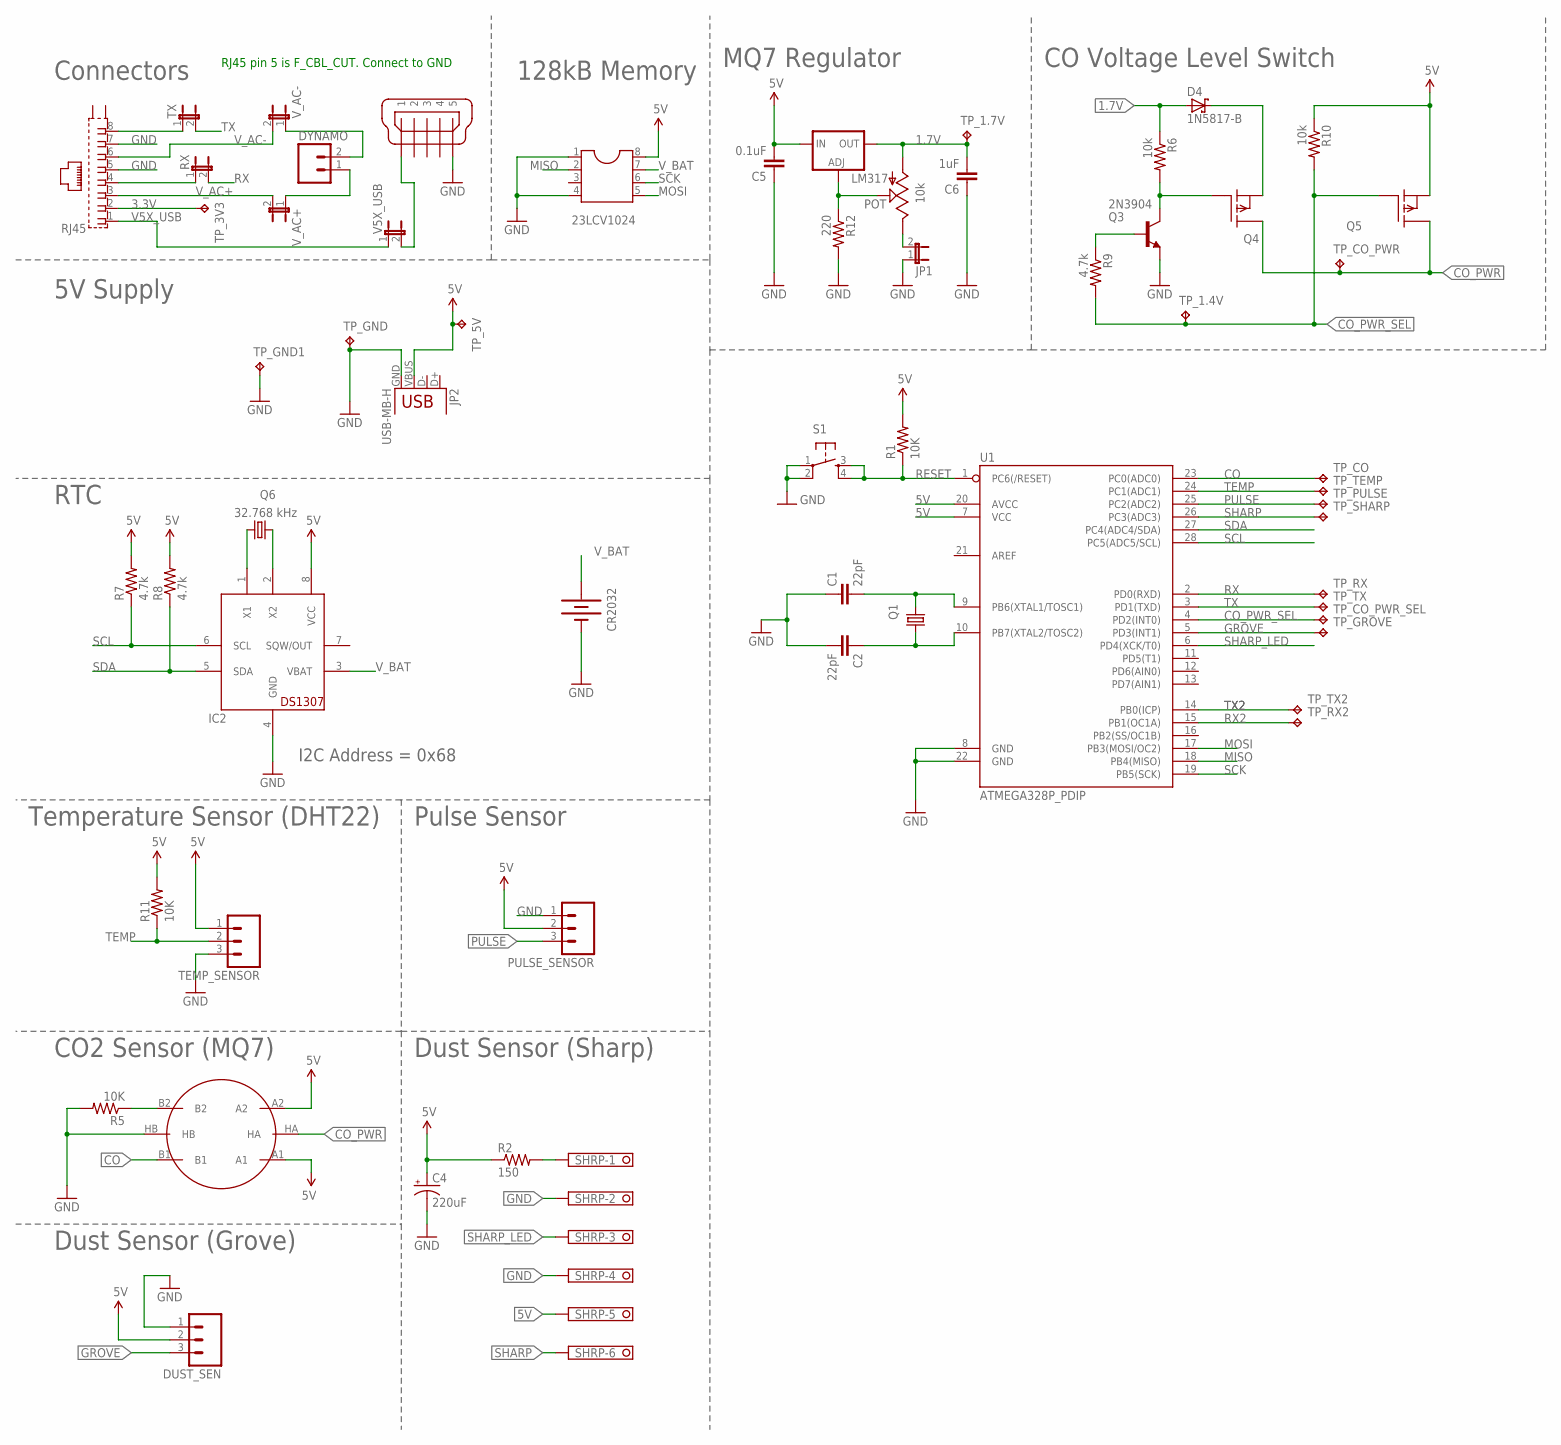
[picture p80: schematic OBI_SlaveBoard_final.sch]

Parts:
23LCV1024: DIL8S; SOCKET-08
C1, C2: 22pF; C025-024X044
C4: 220uF; CPOL-RADIAL-10UF-25V
C5: 0.1uF; C025-024X044
C6: 1uF; C025-024X044
CO2_SENSOR: METHANE_SENSOR; MQ-3
CR2032: BATTERY20PTH; BATTCOM_20MM_PTH
D4: 1N5817-B; DO41-10
DUST_SEN: M03SCREW; SCREWTERMINAL-3.5MM-3
DYNAMO: M023.5MM; SCREWTERMINAL-3.5MM-2
IC2: DS1307; DIL08
JP1: JP1E; JP1
JP2: USB-MB-H
LM317: LM317TS; 317TS
MICROB: MICRO-USB-ZX62R-B-5P; ZX62R-B-5P
POT: 10k; CT6
PULSE_SENSOR: M03SCREW; SCREWTERMINAL-3.5MM-3
Q1: CRYSTALHC49S; HC49/S
Q3: 2N3904; TO-92
Q4, Q5: BSS110; TO92
Q6: 32.768 kHz; TC26V
R1, R5, R11: 10K; 0207/2V
R2: 150; 0207/2V
R6, R10: 10k; 0207/2V
R7, R8, R9: 4.7k; 0207/2V
R12: 220; 0207/2V
RJ45: 0446200002
RX: JP1E; JP1
S1: TAC_SWITCHPTH; TACTILE-PTH
SHRP: 1751280
TEMP_SENSOR: M03SCREW; SCREWTERMINAL-3.5MM-3
TP_1.4V, TP_1.7V, TP_3V3, TP_5V: TPPAD1-13; P1-13
TP_CO: TPPAD1-13; P1-13
TP_CO_PWR: TPPAD1-13; P1-13
TP_CO_PWR_SEL: TPPAD1-13; P1-13
TP_GND, TP_GND1: TPPAD1-13; P1-13
TP_GROVE: TPPAD1-13; P1-13
TP_PULSE: TPPAD1-13; P1-13
TP_RX, TP_RX2: TPPAD1-13; P1-13
TP_SHARP: TPPAD1-13; P1-13
TP_TEMP: TPPAD1-13; P1-13
TP_TX, TP_TX2: TPPAD1-13; P1-13
TX: JP1E; JP1
U1: ATMEGA328P_PDIP; DIL28-3
V5X_USB: JP1E; JP1
V_AC+: JP1E; JP1
V_AC-: JP1E; JP1

Connections:
1.7V: C6.2, D4.A, LM317.2 (OUT), POT.A, R6.1, TP_1.7V.TP
3.3V: RJ45.2, TP_3V3.TP
5V: 23LCV1024.8, C4.1 (+), C5.2, CO2_SENSOR.A1, CO2_SENSOR.A2, DUST_SEN.2, IC2.8 (VCC), JP2.VBUS, LM317.3 (IN), PULSE_SENSOR.2, Q5.1 (S), R1.2, R2.1, R7.2, R8.2, R10.1, R11.2, SHRP.5, TEMP_SENSOR.1, TP_5V.TP, U1.7 (VCC), U1.20 (AVCC)
CO: CO2_SENSOR.B1, TP_CO.TP, U1.23 (PC0(ADC0))
CO_PWR: CO2_SENSOR.HA, Q4.3 (D), Q5.3 (D), TP_CO_PWR.TP
CO_PWR_SEL: Q5.2 (G), R9.2, R10.2, TP_1.4V.TP, TP_CO_PWR_SEL.TP, U1.4 (PD2(INT0))
GND: 23LCV1024.1, 23LCV1024.4, C1.1, C2.2, C4.2 (-), C5.1, C6.1, CO2_SENSOR.HB, CR2032.2 (-), DUST_SEN.1, IC2.4 (GND), JP1.1, JP2.GND, MICROB.5, PULSE_SENSOR.1, Q3.1 (E), R5.2, R12.2, RJ45.5, RJ45.7, S1.1, S1.2, SHRP.2, SHRP.4, TEMP_SENSOR.3, TP_GND.TP, TP_GND1.TP, U1.8 (GND), U1.22 (GND)
GROVE: DUST_SEN.3, TP_GROVE.TP, U1.5 (PD3(INT1))
MISO: 23LCV1024.2, U1.18 (PB4(MISO))
MOSI: 23LCV1024.5, U1.17 (PB3(MOSI/OC2))
unnamed: IC2.1 (X1), Q6.1
unnamed: Q3.3 (C), Q4.2 (G), R6.2
unnamed: C1.2, Q1.2, U1.9 (PB6(XTAL1/TOSC1))
unnamed: Q3.2 (B), R9.1
unnamed: C2.1, Q1.1, U1.10 (PB7(XTAL2/TOSC2))
unnamed: IC2.2 (X2), Q6.2
unnamed: RJ45.4, RX.1
unnamed: R2.2, SHRP.1
unnamed: LM317.1 (ADJ), POT.S, R12.1
unnamed: RJ45.8, TX.1
unnamed: DYNAMO.1, V_AC+.1
unnamed: MICROB.1, V5X_USB.2
unnamed: JP1.2, POT.E
unnamed: DYNAMO.2, V_AC-.1
unnamed: D4.C, Q4.1 (S)
unnamed: CO2_SENSOR.B2, R5.1
PULSE: PULSE_SENSOR.3, TP_PULSE.TP, U1.25 (PC2(ADC2))
RESET: R1.1, S1.3, S1.4, U1.1 (PC6(/RESET))
RX: RX.2, TP_RX.TP, U1.2 (PD0(RXD))
RX2: TP_RX2.TP, U1.15 (PB1(OC1A))
SCK: 23LCV1024.6, U1.19 (PB5(SCK))
SCL: IC2.6 (SCL), R7.1, U1.28 (PC5(ADC5/SCL))
SDA: IC2.5 (SDA), R8.1, U1.27 (PC4(ADC4/SDA))
SHARP: SHRP.6, TP_SHARP.TP, U1.26 (PC3(ADC3))
SHARP_LED: SHRP.3, U1.6 (PD4(XCK/T0))
TEMP: R11.1, TEMP_SENSOR.2, TP_TEMP.TP, U1.24 (PC1(ADC1))
TX: TP_TX.TP, TX.2, U1.3 (PD1(TXD))
TX2: TP_TX2.TP, U1.14 (PB0(ICP))
V5X_USB: RJ45.1, V5X_USB.1
V_AC+: RJ45.3, V_AC+.2
V_AC-: RJ45.6, V_AC-.2
V_BAT: 23LCV1024.7, CR2032.1 (+), IC2.3 (VBAT)

Notes on the sheet:
Connectors
5V Supply
RTC
Temperature Sensor (DHT22)
Pulse Sensor
CO2 Sensor (MQ7)
I2C Address = 0x68
Dust Sensor (Sharp)
Dust Sensor (Grove)
128kB Memory
MQ7 Regulator
CO Voltage Level Switch
RJ45 pin 5 is F_CBL_CUT. Connect to GND

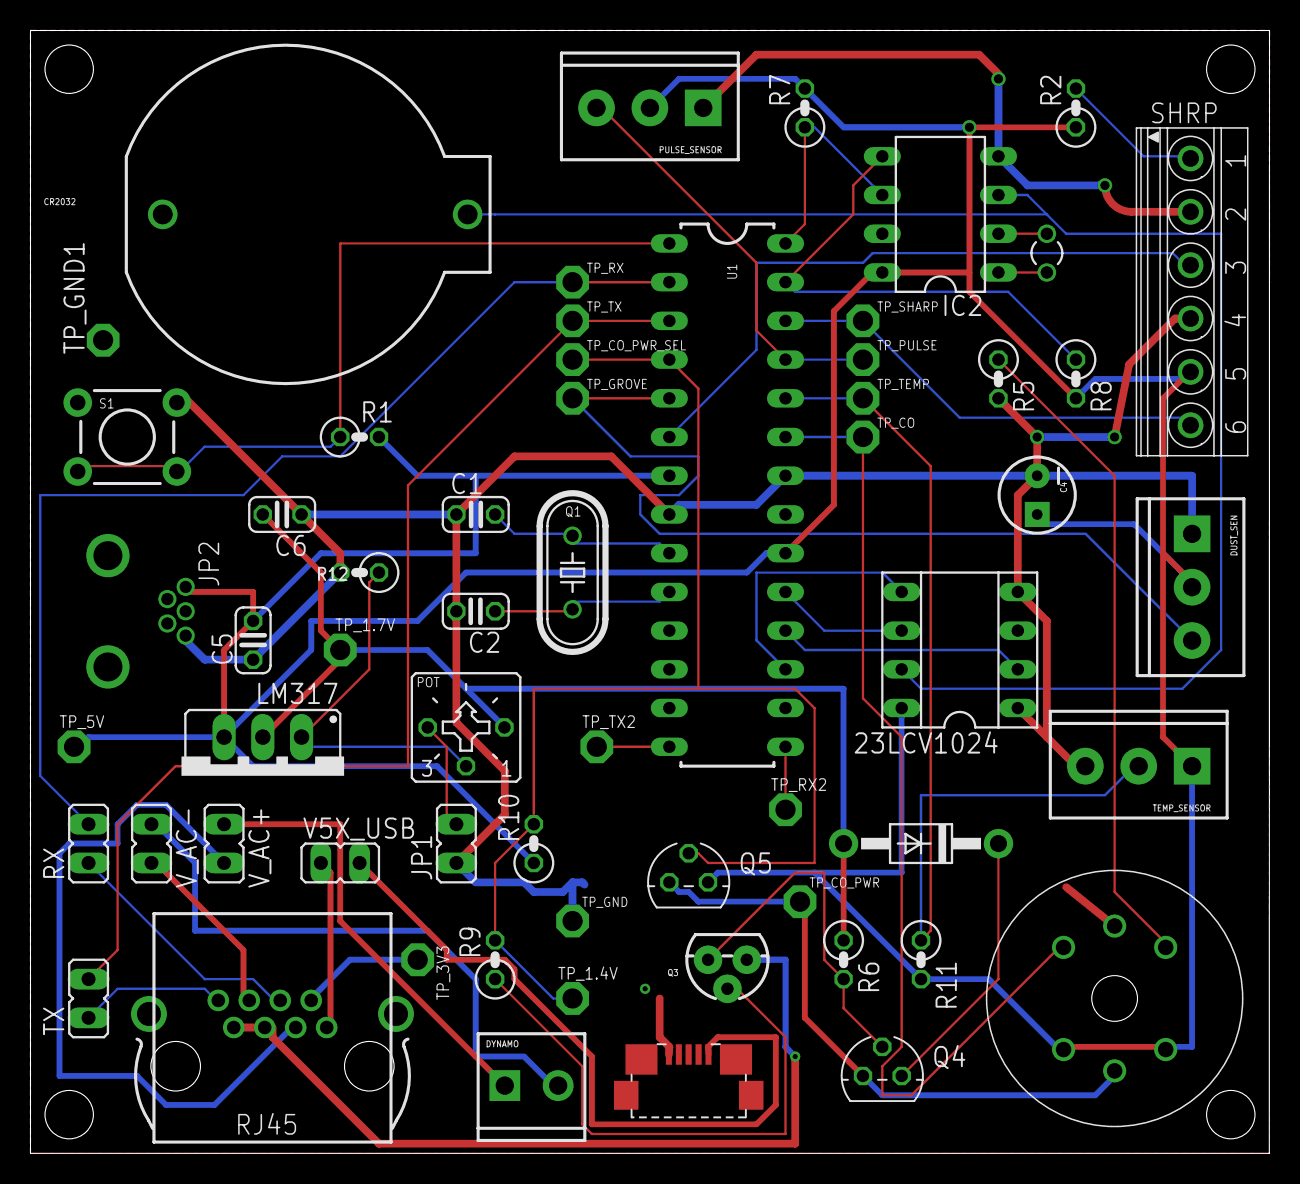
[picture p81: board OBI_SlaveBoard_final.brd from above]

Board: 2 copper layers, 81.3 x 73.7 mm, 60 parts (0 on the bottom side), 42 nets.
