alaviali/OBI/Layout/OBI_SlaveBoard_rev1.brd

## EAGLE design Layout/OBI_SlaveBoard_rev1.brd (2015-04-19)

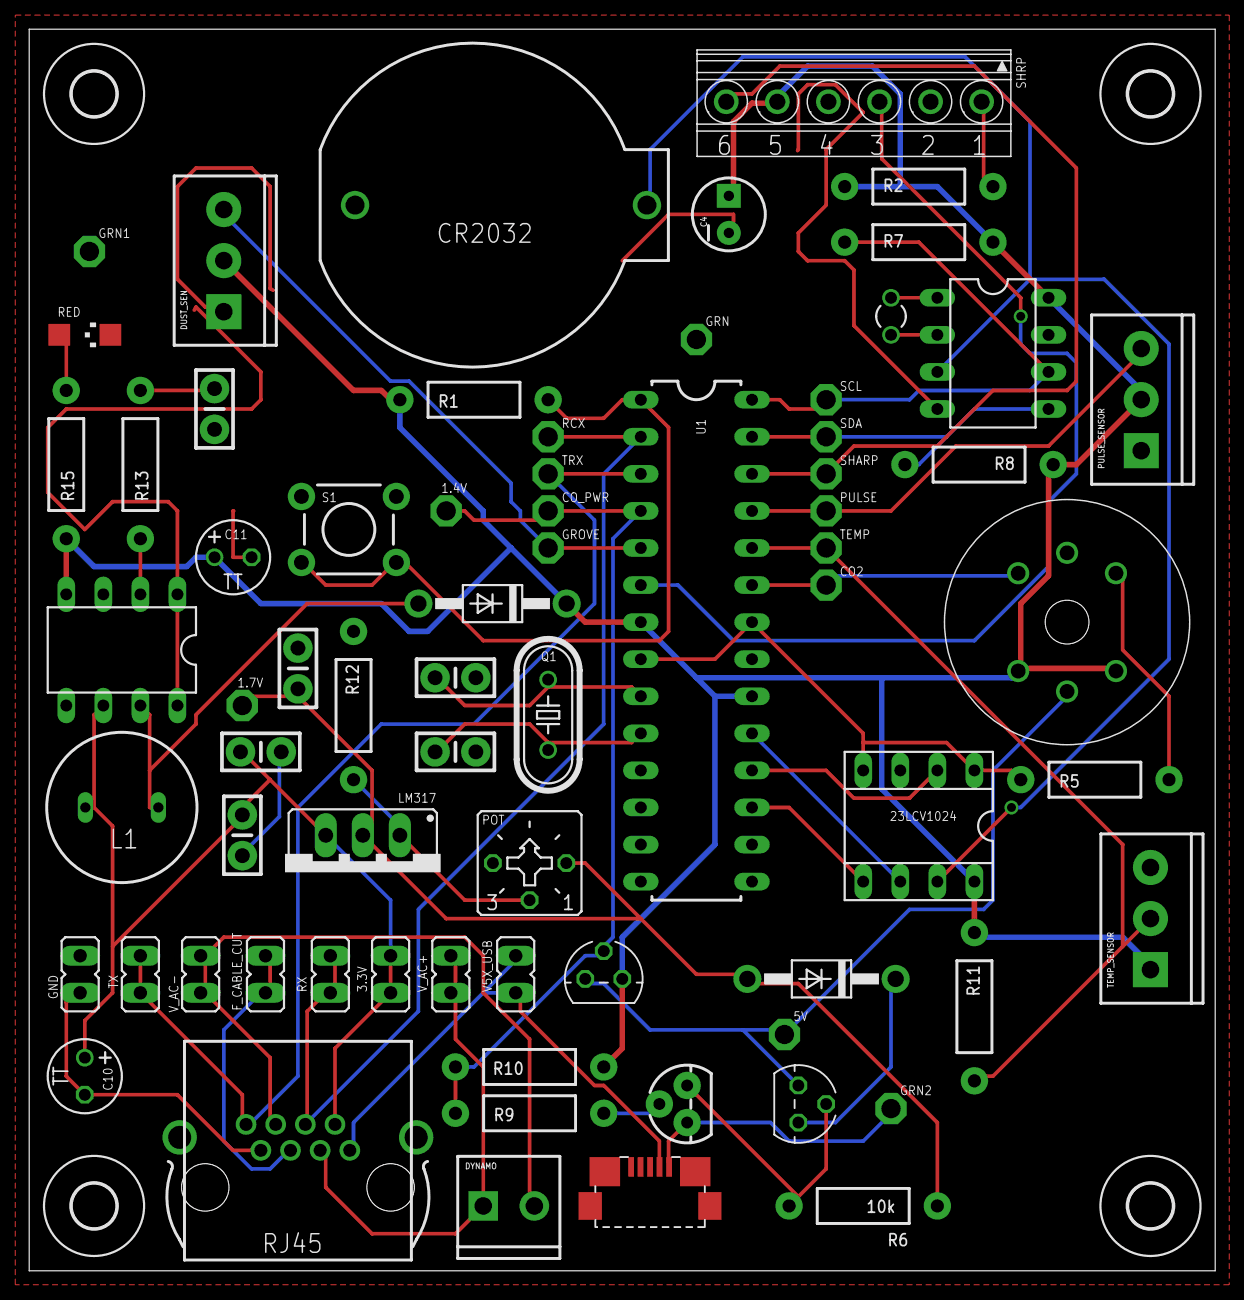
[picture p82: board OBI_SlaveBoard_rev1.brd from above]

Board: 2 copper layers, 81.3 x 85.1 mm, 75 parts (0 on the bottom side), 39 nets.

Parts:
1.4V, 1.7V, 5V: TPPAD1-13; P1-13
3.3V: JP1
23LCV1024: SOCKET-08
C1, C2: 22pF; CAP-PTH-SMALL-KIT
C4: 220uF; CPOL-RADIAL-10UF-25V
C5, C9: 0.1uF; CAP-PTH-SMALL-KIT
C6: 1uF; CAP-PTH-SMALL-KIT
C8: 0.01uF; CAP-PTH-SMALL-KIT
C10, C11: 100uF; TT2D5
CO2: TPPAD1-13; P1-13
CO2_SENSOR: METHANE_SENSOR; MQ-3
CO_PWR: TPPAD1-13; P1-13
CR2032: BATTCOM_20MM_PTH
D1, D4: 1N5817-B; DO41-10
DUST_SEN: SCREWTERMINAL-3.5MM-3
DYNAMO: SCREWTERMINAL-3.5MM-2
FRAME1: FRAME-LEDGER; CREATIVE_COMMONS
F_CABLE_CUT: JP1
GND: JP1
GRN, GRN1, GRN2: TPPAD1-13; P1-13
GROVE: TPPAD1-13; P1-13
IC2: DS1307; DIL08
L1: 10uH; BS11
LM317: 317TS
MICROB: MICRO-USB-ZX62R-B-5P; ZX62R-B-5P
POT: 10k; CT6
PULSE: TPPAD1-13; P1-13
PULSE_SENSOR: SCREWTERMINAL-3.5MM-3
Q1: HC49/S
Q3: 2N3904; TO-92
Q4, Q5: BSS110; TO92
Q6: 32.768 kHz; TC26V
R1, R5, R11: 10K; AXIAL-0.4
R2: 150; AXIAL-0.4
R6, R10: 10k; AXIAL-0.4
R7, R8, R9: 4.7k; AXIAL-0.4
R12: 220; AXIAL-0.4
R13: 20k; AXIAL-0.4
R15: 180; AXIAL-0.4
RCX: TPPAD1-13; P1-13
RED: CHIPLED_1206
RJ45: 0446200002
RX: JP1
S1: TACTILE-PTH
SCL: TPPAD1-13; P1-13
SDA: TPPAD1-13; P1-13
SHARP: TPPAD1-13; P1-13
SHRP: 1751280
TEMP: TPPAD1-13; P1-13
TEMP_SENSOR: SCREWTERMINAL-3.5MM-3
TRX: TPPAD1-13; P1-13
TX: JP1
U1: ATMEGA328P_PDIP; DIL28-3
U$1, U$2, U$3, U$4: 3,0
V5X_USB: JP1
V_AC+: JP1
V_AC-: JP1
V_BOOST: LT1302; DIL08

Connections:
1.7V: 1.7V.TP, C6.2, D4.A, LM317.2, POT.A, R6.P$1
3.3V: 3.3V.1, 3.3V.2, C5.2, C9.1, C10.+, L1.2, LM317.3, RJ45.2, V_BOOST.6
5V: 23LCV1024.8, C4.1, C11.+, CO2_SENSOR.A1, CO2_SENSOR.A2, D1.C, DUST_SEN.2, IC2.8, PULSE_SENSOR.2, Q5.1, R1.P$2, R2.P$1, R7.P$2, R8.P$2, R10.P$1, R11.P$2, R15.P$2, SHRP.5, TEMP_SENSOR.1, U1.7, U1.20, V_BOOST.4
CO2: CO2.TP, CO2_SENSOR.B1, U1.23
CO_PWR: 5V.TP, CO2_SENSOR.HA, Q4.3, Q5.3
CO_PWR_SEL: 1.4V.TP, CO_PWR.TP, Q5.2, R9.P$2, R10.P$2, U1.4
F_CABLE_CUT: F_CABLE_CUT.1, F_CABLE_CUT.2, RJ45.5
GND: 23LCV1024.1, 23LCV1024.4, C1.1, C2.2, C4.2, C5.1, C6.1, C8.1, C9.2, C10.-, C11.-, CO2_SENSOR.HB, CR2032.2, DUST_SEN.1, GND.1, GND.2, GRN.TP, GRN1.TP, GRN2.TP, IC2.4, MICROB.1, POT.E, PULSE_SENSOR.1, Q3.1, R5.P$2, R12.P$2, RED.C, RJ45.7, S1.1, S1.2, SHRP.2, SHRP.4, TEMP_SENSOR.3, U1.8, U1.22, V_BOOST.1, V_BOOST.8
GROVE: DUST_SEN.3, GROVE.TP, U1.5
MISO: 23LCV1024.2, U1.18
MOSI: 23LCV1024.5, U1.17
unnamed: IC2.1, Q6.1
unnamed: Q3.3, Q4.2, R6.P$2
unnamed: C1.2, Q1.2, U1.9
unnamed: Q3.2, R9.P$1
unnamed: C2.1, Q1.1, U1.10
unnamed: IC2.2, Q6.2
unnamed: R15.P$1, RED.A
unnamed: R2.P$2, SHRP.1
unnamed: LM317.1, POT.S, R12.P$1
unnamed: R13.P$2, V_BOOST.2
unnamed: D4.C, Q4.1
unnamed: CO2_SENSOR.B2, R5.P$1
unnamed: C8.2, R13.P$1
unnamed: D1.A, L1.1, V_BOOST.7
PULSE: PULSE.TP, PULSE_SENSOR.3, U1.25
RESET: R1.P$1, S1.3, S1.4, U1.1
RX: RCX.TP, RJ45.4, RX.1, RX.2, U1.2
SCK: 23LCV1024.6, U1.19
SCL: IC2.6, R7.P$1, SCL.TP, U1.28
SDA: IC2.5, R8.P$1, SDA.TP, U1.27
SHARP: SHARP.TP, SHRP.6, U1.26
SHARP_LED: SHRP.3, U1.6
TEMP: R11.P$1, TEMP.TP, TEMP_SENSOR.2, U1.24
TX: RJ45.8, TRX.TP, TX.1, TX.2, U1.3
V5X_USB: MICROB.2, RJ45.1, V5X_USB.1, V5X_USB.2
V_AC+: DYNAMO.1, RJ45.3, V_AC+.1, V_AC+.2
V_AC-: DYNAMO.2, RJ45.6, V_AC-.1, V_AC-.2
V_BATT: 23LCV1024.7, CR2032.1, IC2.3
