alaviali/OBI/(commit log)

2015-02-03 Alex Bigazzi's Source Code
    The Arduino Source code for the Portland ACE project.
2015-03-02 Dust sensor code
2015-03-02 CO sensor code
    Working code for CO sensor. Switches the relay for high (60s) and low
    (90s) voltage of the sensor. Also prints the time and the output value..
2015-03-04 Sample code from Adafruit
2015-03-09 Pulse Sensor
    Pulse Sensor Arduino Uno code
2015-03-26 Sharp dust sensor sample code
2015-03-30 Rewrote the 2-mode dust sensor code
    Check worklog on Google Drive for more details
2015-03-30 Rewrote the 2-mode Sharp sensor code
    Refer to worklog for more details
2015-04-01 Sharp rewritten, interrupt only, 4s interval
    See worklog in Google Drive for details
2015-04-01 Grove rewritten, interrupt only, 4s interval
    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
2015-04-01 MQ7 rewritten, interrupt only, 4s interval
    see worklong in Google Drive for details
2015-04-08 DHT22 rewritten, interrupt only, 4s interval
    See worklog on Google Drive for more details
2015-04-13 Pulse sensor rewritten first draft
    Needs work
2015-04-13 Pulse sensor improved
    prints every 1s, changed timer 2 to timer 1
2015-04-13 1st merge without pulse sensor
2015-04-13 2nd merge without pulse sensor
2015-04-16 Added pin setup
2015-04-19 Schematic and Layout
    All the revisions of the schematics and layouts
    [OBI_SlaveBoard_final.brd, OBI_SlaveBoard_final.sch, OBI_SlaveBoard_rev1.brd, OBI_SlaveBoard_rev1.sch, OBI_SlaveBoard_rev2.sch, OBI_SlaveBoard_rev3.sch, OBI_SlaveBoard_rev4.sch, OBI_SlaveBoard_rev5.sch]
2015-04-19 images
    pictures of schematic and board
2015-04-20 New pulse sensor code, polling based
2015-04-20 Pulse sensor added
    pulse sensor outputs constant zeros. PIN setup is corrected and
    verified.
    [Merged.ino]
2015-04-27 Memory code updated
    Problem is in hardware
    [Memory.ino]
2015-04-27 Memory tested with Grove sensor
    See worklog for details
2015-05-07 Added memory sample code. Added real time clock sample code.
2015-05-13 Complete refactoring of Merged.ino code. Added RTC code, serial communication Completed memory code. Had to move sensor reading code out of ISR since RTC code inside the ISR causes the chip to freeze.
2015-05-16 All sensors, GPS and SD card running on frontbox only. GPS uses harware serial because SoftwareSerial corrupts memory operations to either SD or memory chip.
2015-05-17 Added file to libraries directory so compilation can be done using Arduino IDE
2015-05-27 Version of code running on prototype and box going to DC
2015-06-04 Changed delay for Sharp sensor to microseconds. Modified grove sensor timing.
2015-06-07 documents for wiki
    adjusted requirements, capstone presentation pdf, modified schematic,
    adjusted proposal
2015-06-09 Cleanup and slight modification of grove sensor code.
