alaviali/OBI/Poster Presentation/OBI AQSH Poster_final1.jpg

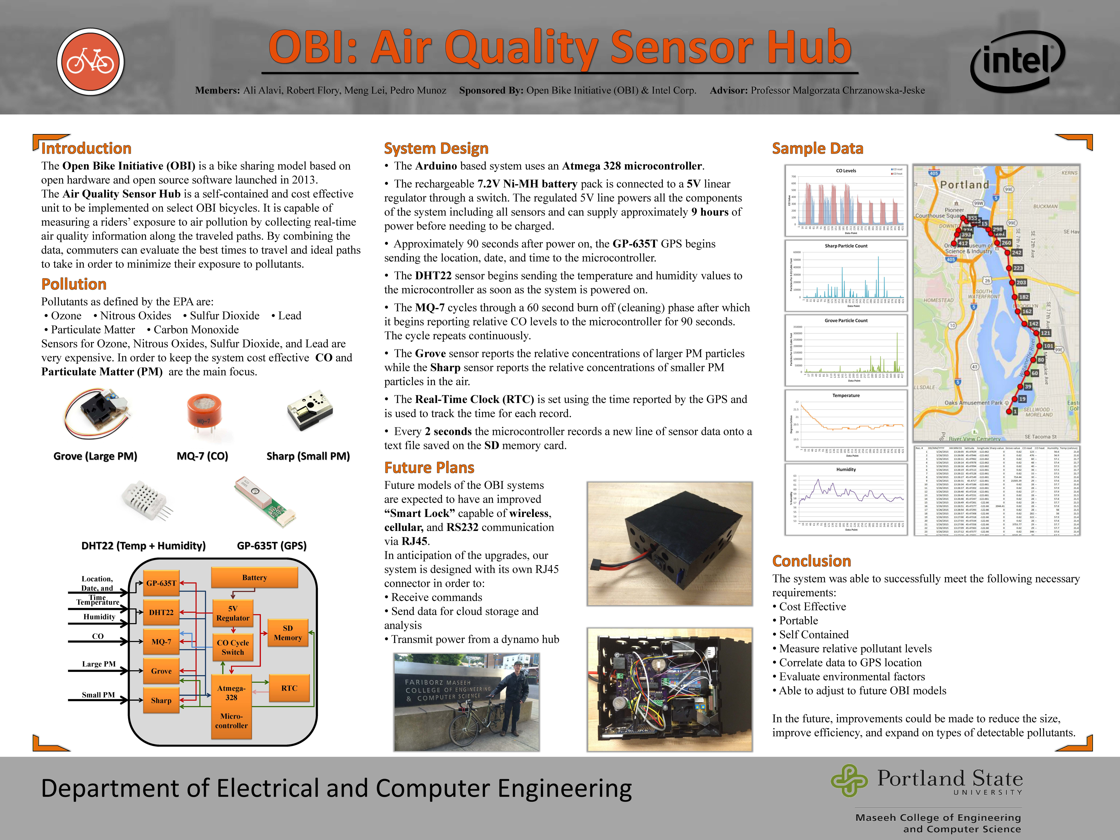
Poster Presentation/OBI AQSH Poster_final1.jpg
